pmusgrave/synth-wavetable/Cypress/ComponentUpdateLog.txt

Last Modified Date & Time: 09/27/2019 14:22:59

synth-wavetable: TopDesign.cysch
	USB [v3.10] to [v3.20]

Last Modified Date & Time: 09/27/2019 14:25:36

synth-wavetable: TopDesign.cysch
	CodecI2CM [v4.0] to [v3.20]
	UART [v4.0] to [v3.20]
	USB [v3.20] to [v3.10]

Last Modified Date & Time: 09/27/2019 14:26:23

synth-wavetable: TopDesign.cysch
	CodecI2CM [v3.20] to [v4.0]
	UART [v3.20] to [v4.0]
	USB [v3.10] to [v3.20]

Last Modified Date & Time: 09/27/2019 14:26:39

synth-wavetable: TopDesign.cysch
	CodecI2CM [v4.0] to [v3.20]
	UART [v4.0] to [v3.20]

Last Modified Date & Time: 09/27/2019 14:26:55

synth-wavetable: TopDesign.cysch
	USB [v3.20] to [v3.10]

Last Modified Date & Time: 09/27/2019 14:36:18

synth-wavetable: TopDesign.cysch
	CodecI2CM [v3.20] to [v4.0]
	UART [v3.20] to [v4.0]
