pmusgrave/synth-wavetable/Hardware/synth-engine/synth-wavetable.pdf

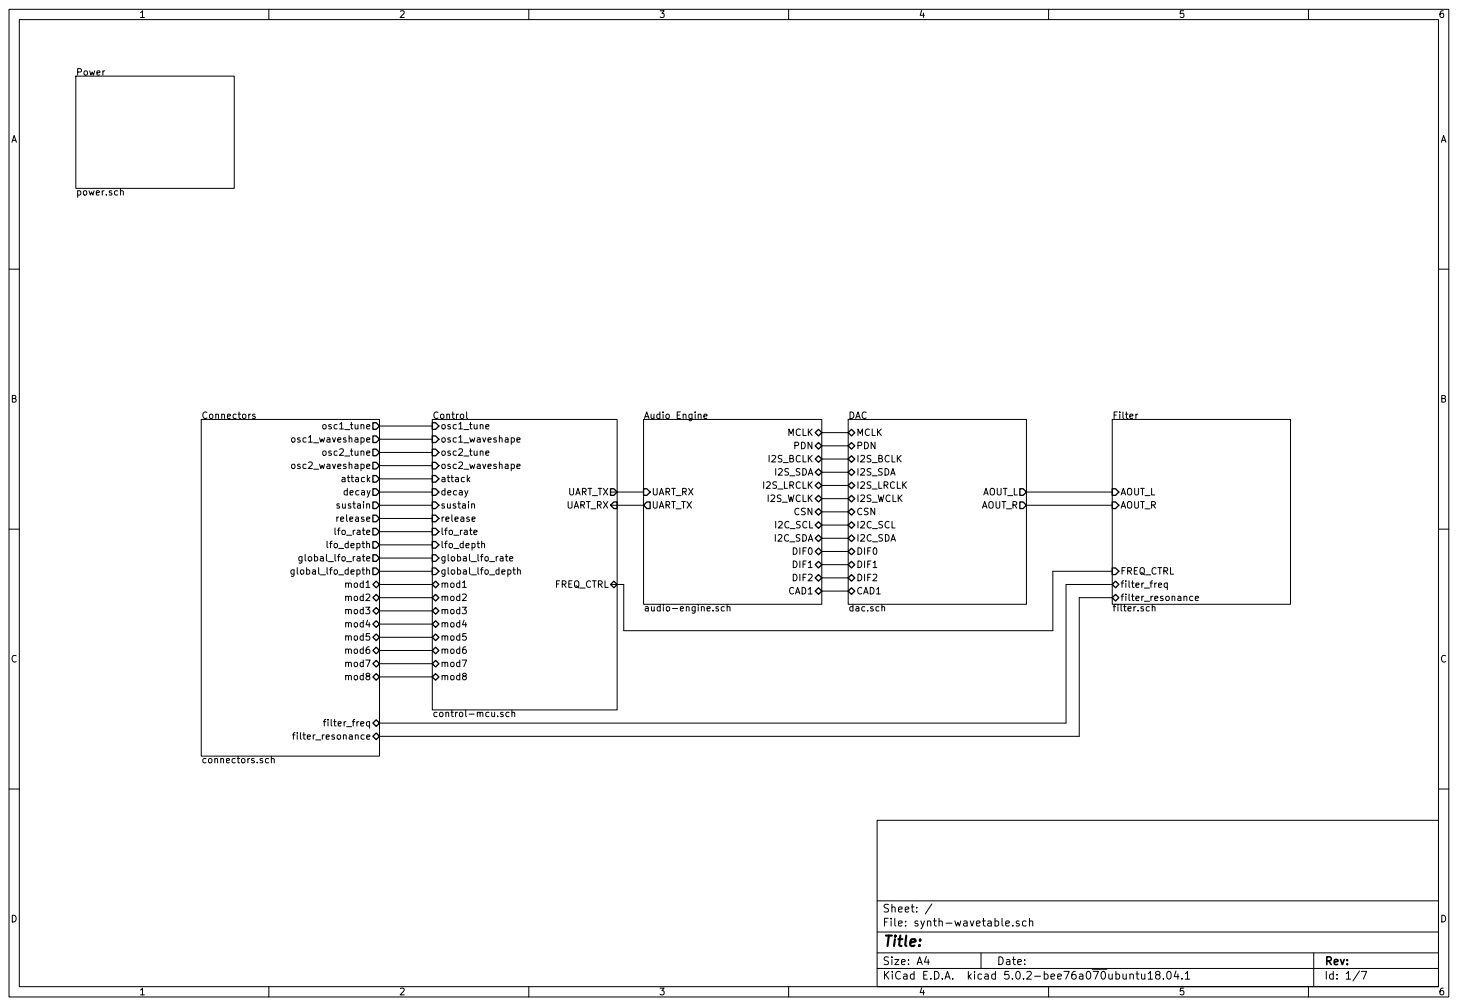
[picture p1: page 1]

File: synth-wavetable.sch Sheet: /
Id: 1/7 Title:

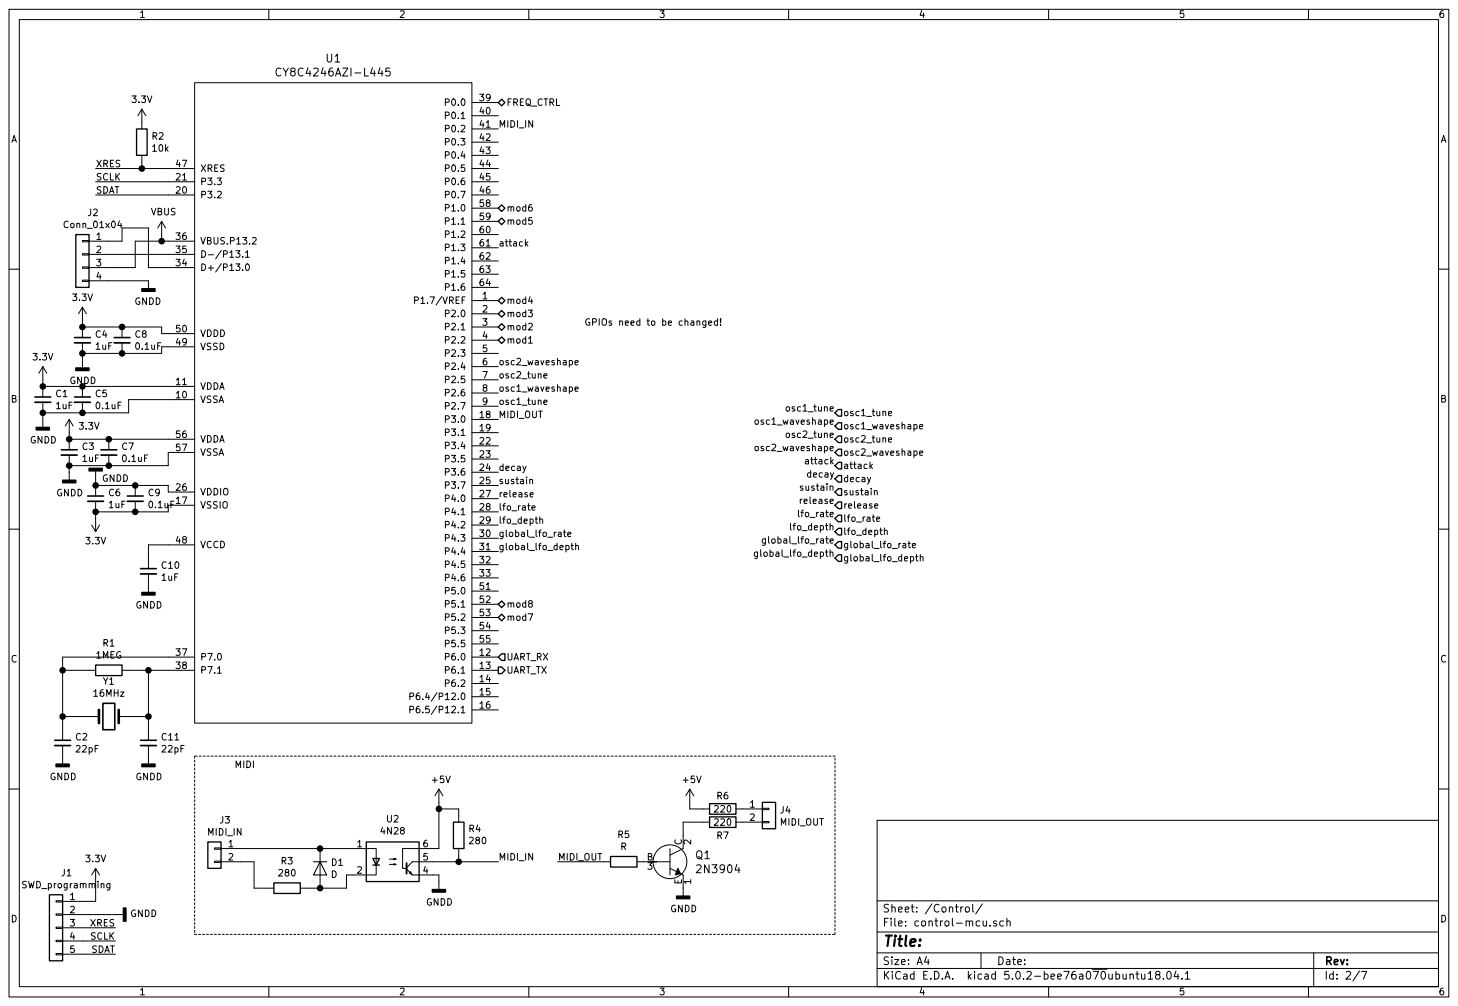
[picture p2: page 2]

GPIOs need to be changed! FREQ_CTRL mod1 mod2 mod3 mod4 mod5 mod6 mod7 mod8 VBUS 1234

Id: 2/7 Title: File: control-mcu.sch Sheet: /Control/

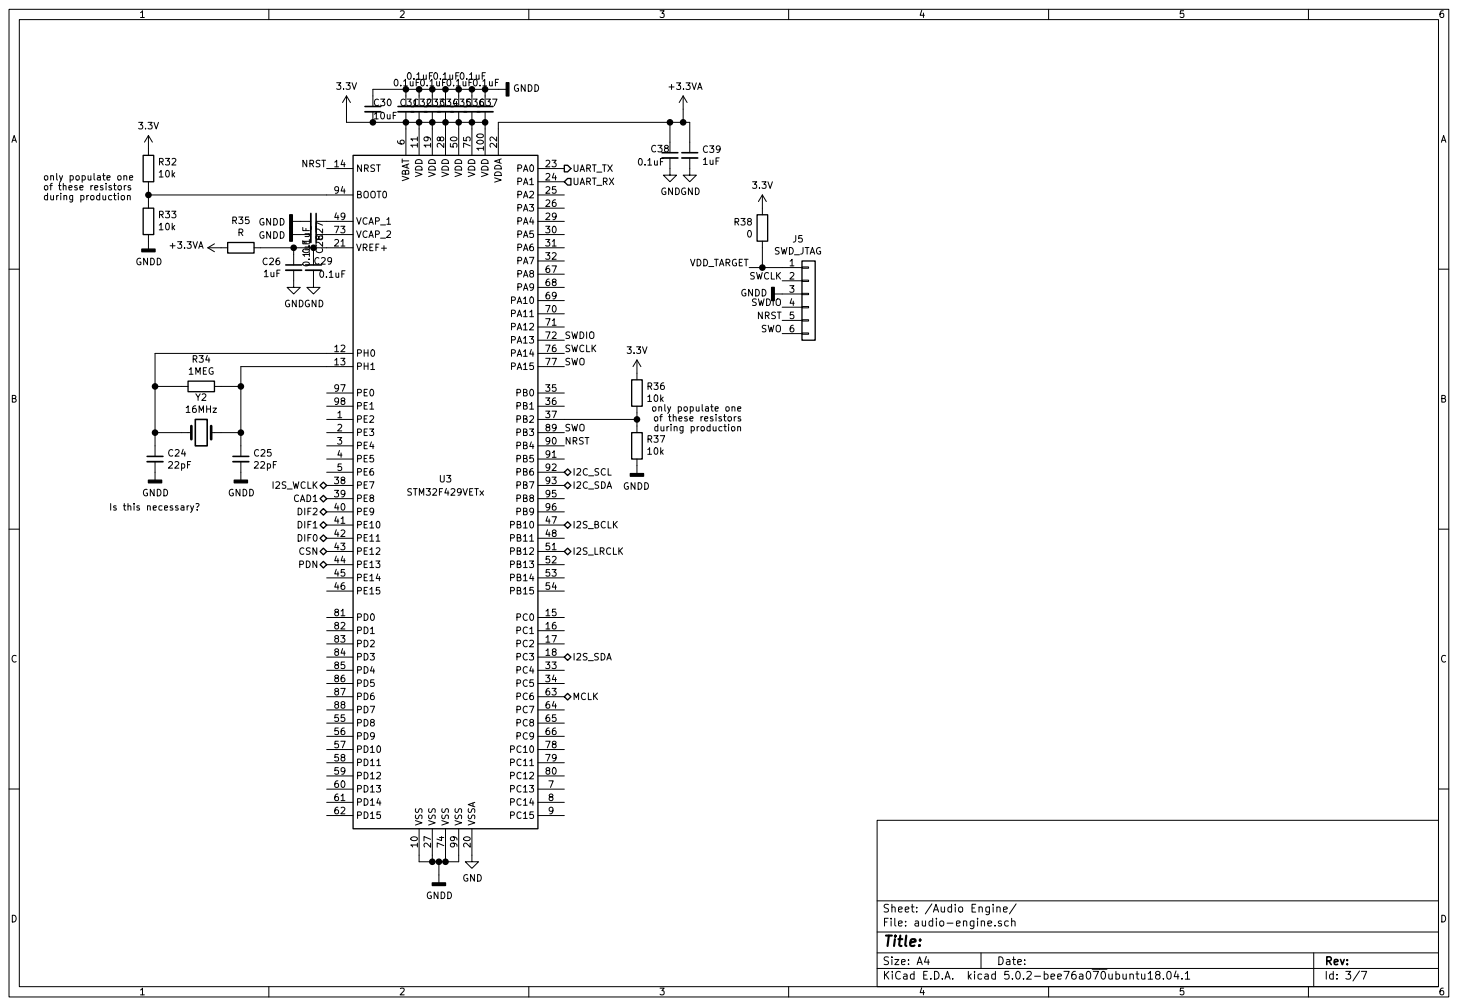
[picture p3: page 3]

10k only populate one
of these resistors during production

Sheet: /Audio Engine/
File: audio-engine.sch
Id: 3/7 Title:

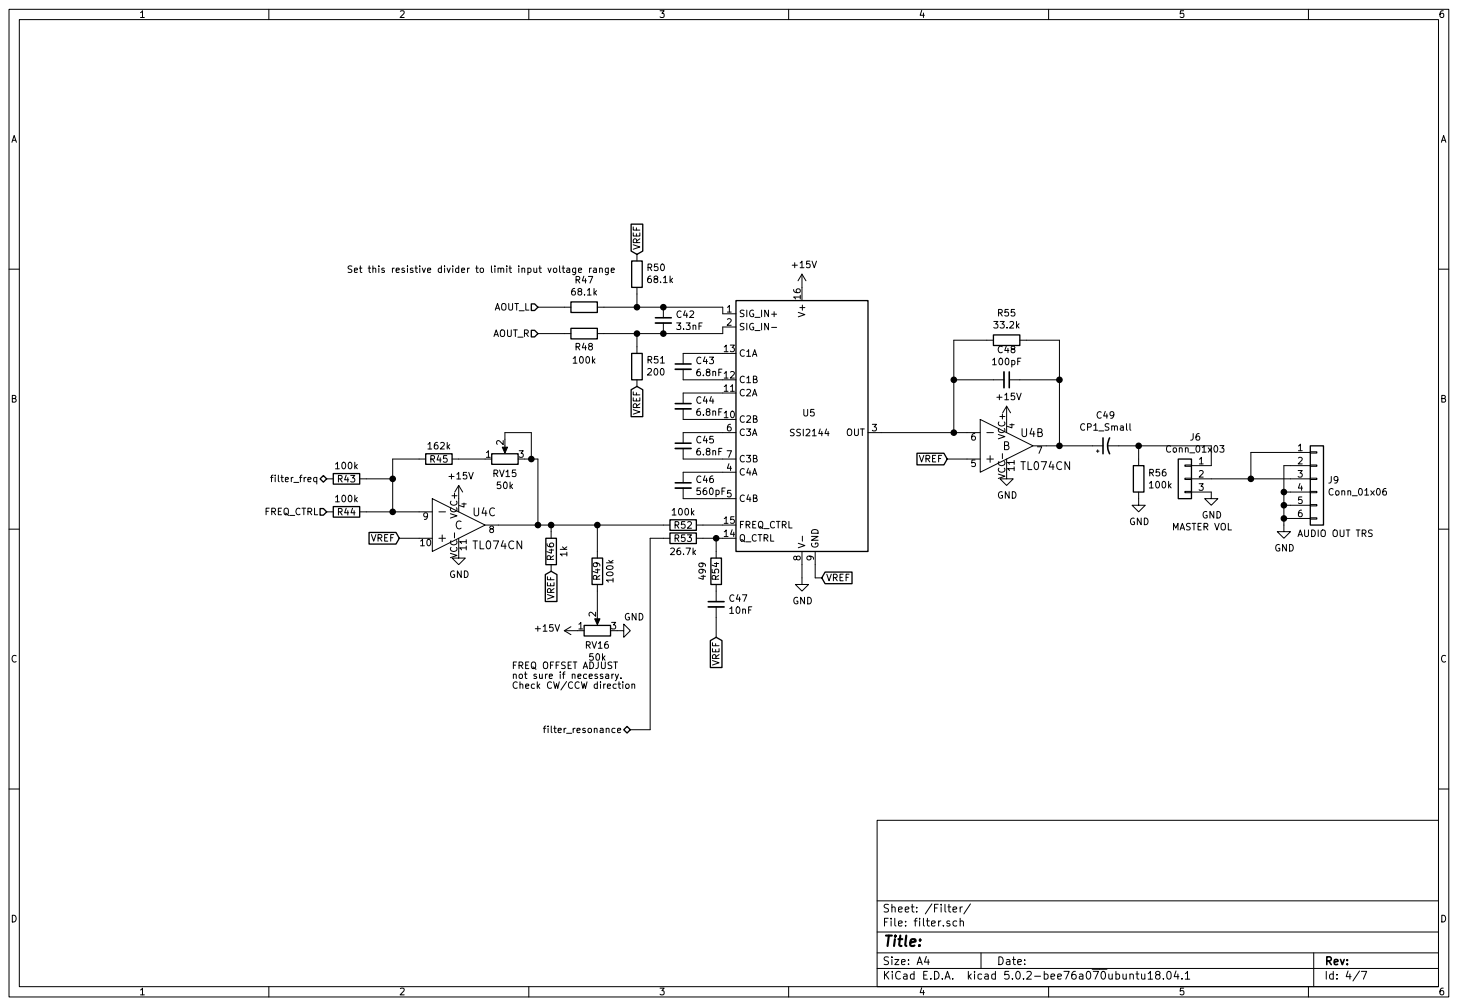
[picture p4: page 4]

68.1k Set this resistive divider to limit input voltage range R43

FREQ OFFSET ADJUST
not sure if necessary. Check CW/CCW direction

Id: 4/7 Title: File: filter.sch Sheet: /Filter/

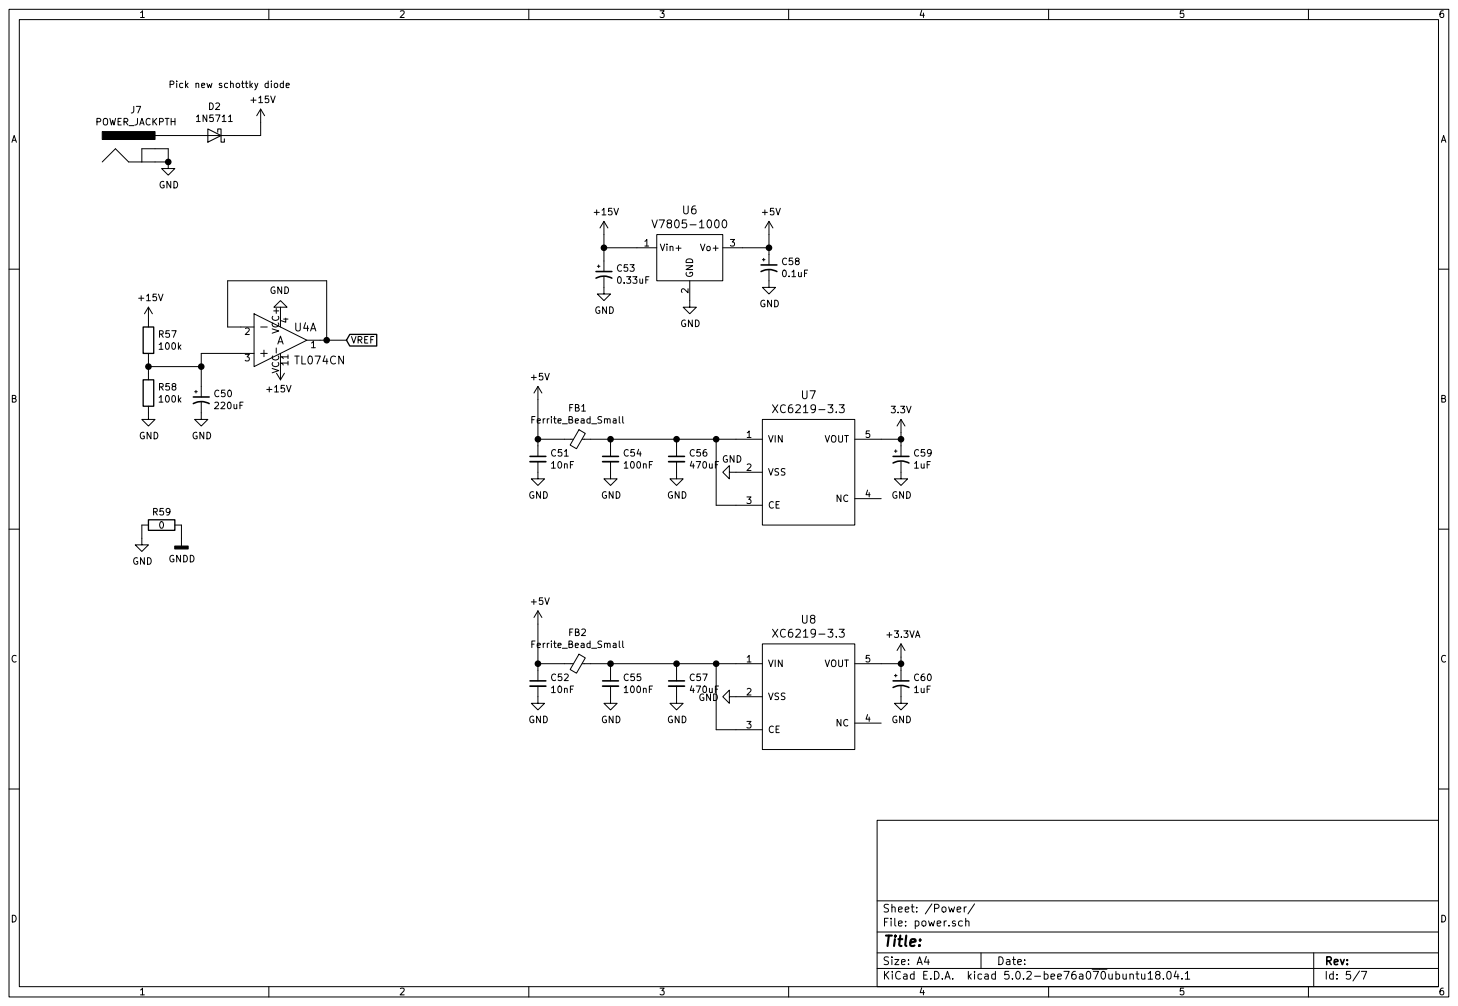
[picture p5: page 5]

1N5711 Pick new schottky diode

File: power.sch Sheet: /Power/
Id: 5/7 Title:

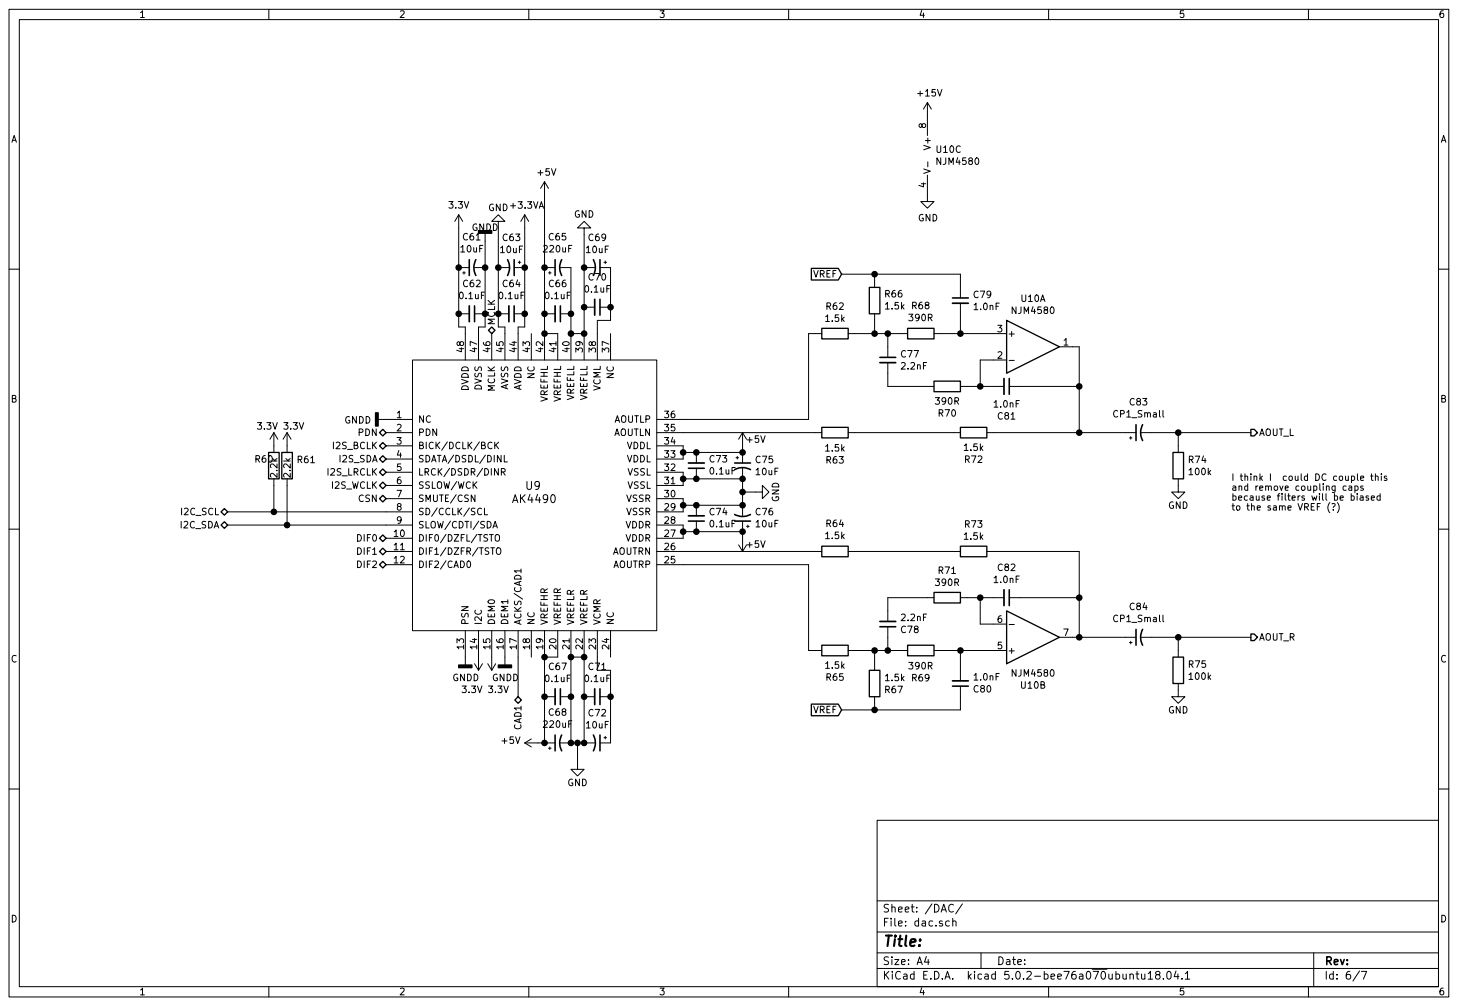
[picture p6: page 6]

I think I could DC couple this
and remove coupling caps because filters will be biased
to the same VREF (?)

Id: 6/7 Title: File: dac.sch Sheet: /DAC/

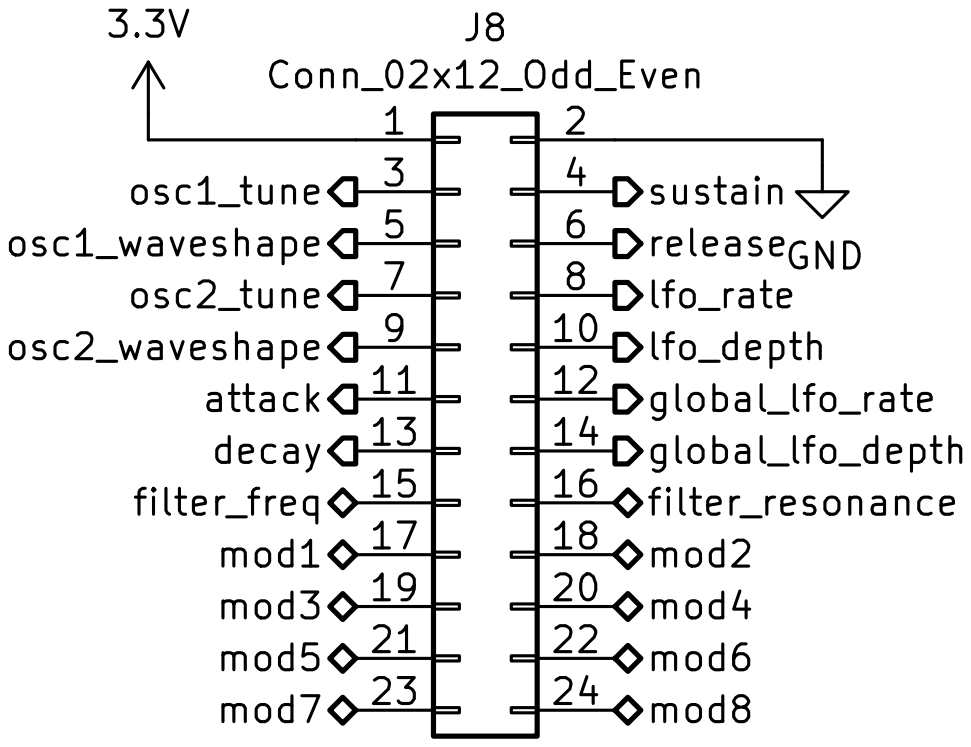
[picture p7: page 7]

Id: 7/7 Title: File: connectors.sch Sheet: /Connectors/
