pmusgrave/synth-wavetable/Hardware/synth-engine/synth-wavetable.kicad_pcb

## KiCad design Hardware/synth-engine/synth-wavetable.kicad_pcb (2019-12-03)

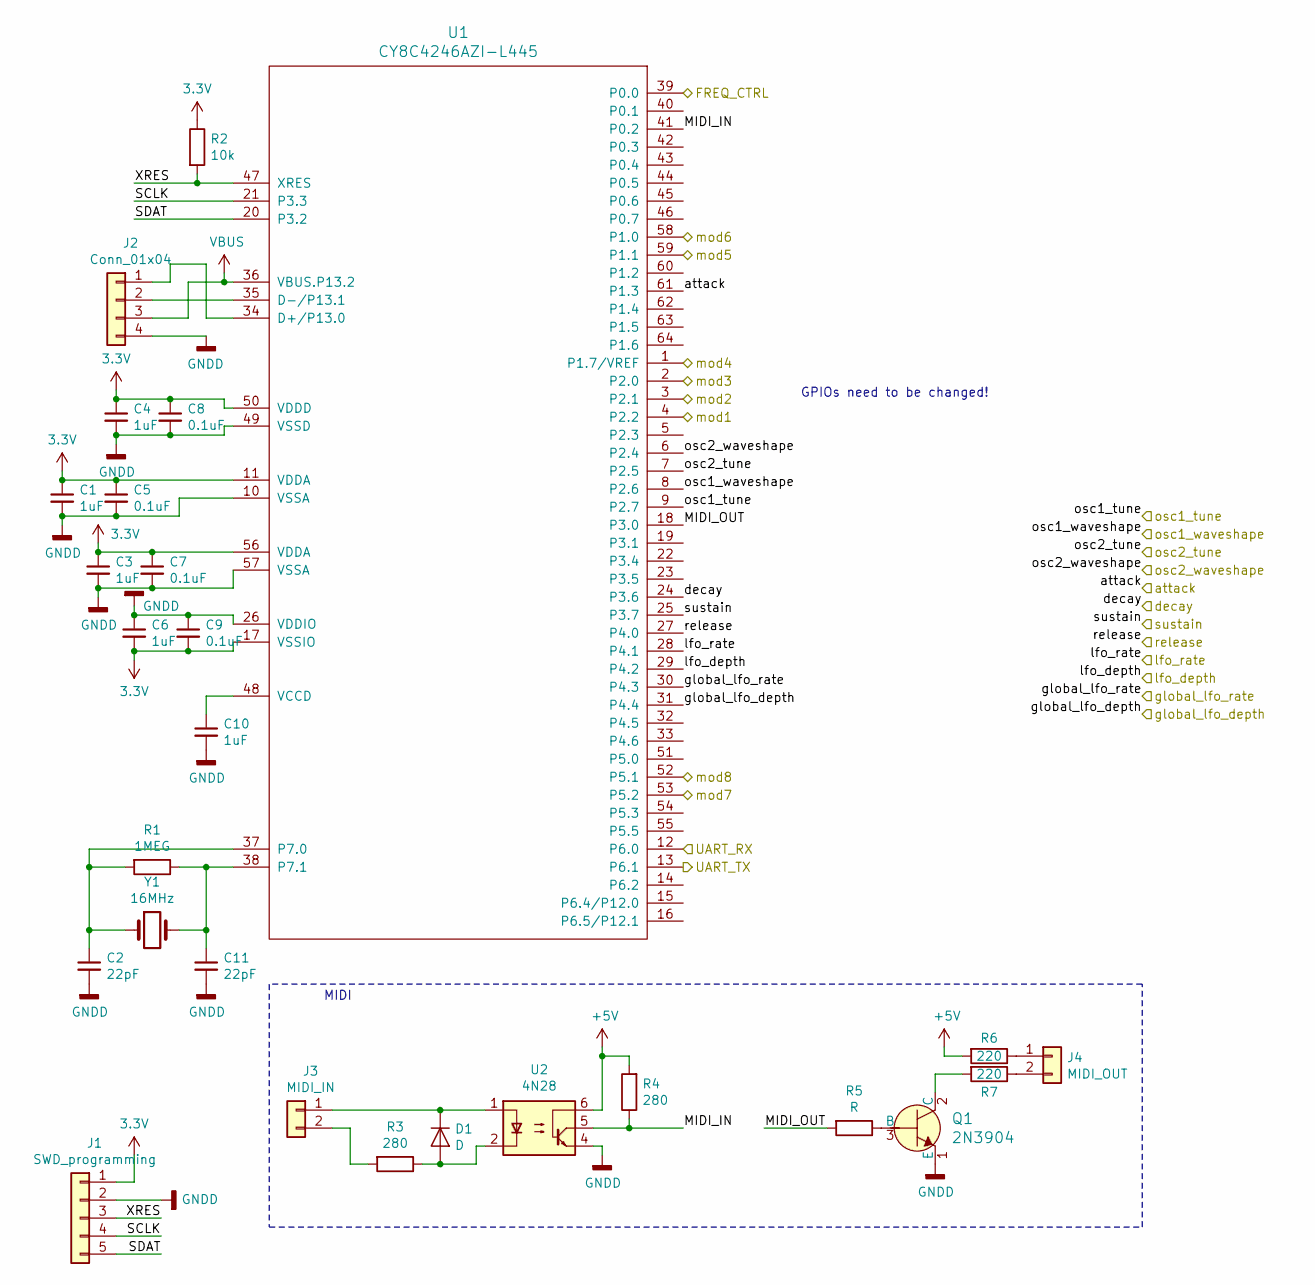
[picture p8: schematic control-mcu.sch]

Parts:
C1, C3, C4, C6, C10: 1uF; 0805
C2, C11: 22pF; 0805
C5, C7, C8, C9: 0.1uF; 0805
D1: D; 1210
J1: SWD_programming; 1X05
J2: Conn_01x04; 1X04
J3: MIDI_IN; 1X02
J4: MIDI_OUT; 1X02
Q1: 2N3904; SOT23-3; MPN 2N3904; Digi-Key_PN 2N3904CS-ND
R1: 1MEG; 0805
R2: 10k; 0805
R3, R4: 280; 0805
R5: R; 0805
R6, R7: 220; 0805
U1: CY8C4246AZI-L445; TQFP64
U2: 4N28; DIL-08
Y1: 16MHz; Crystal_SMD_HC49-SD_HandSoldering

Connections:
3.3V: C1.1, C3.1, C4.1, C5.1, C6.2, C7.1, C8.1, C9.2, J1.1, R2.1, U1.11 (VDDA), U1.17 (VSSIO), U1.50 (VDDD), U1.56 (VDDA); also elsewhere on the board
+5V: R4.2, R6.2, U2.6; also elsewhere on the board
/Connectors/attack: U1.61 (P1.3); also elsewhere on the board
/Connectors/decay: U1.24 (P3.6); also elsewhere on the board
/Connectors/global_lfo_depth: U1.31 (P4.4); also elsewhere on the board
/Connectors/global_lfo_rate: U1.30 (P4.3); also elsewhere on the board
/Connectors/lfo_depth: U1.29 (P4.2); also elsewhere on the board
/Connectors/lfo_rate: U1.28 (P4.1); also elsewhere on the board
/Connectors/mod1: U1.4 (P2.2); also elsewhere on the board
/Connectors/mod2: U1.3 (P2.1); also elsewhere on the board
/Connectors/mod3: U1.2 (P2.0); also elsewhere on the board
/Connectors/mod4: U1.1 (P1.7/VREF); also elsewhere on the board
/Connectors/mod5: U1.59 (P1.1); also elsewhere on the board
/Connectors/mod6: U1.58 (P1.0); also elsewhere on the board
/Connectors/mod7: U1.53 (P5.2); also elsewhere on the board
/Connectors/mod8: U1.52 (P5.1); also elsewhere on the board
/Connectors/osc1_tune: U1.9 (P2.7); also elsewhere on the board
/Connectors/osc1_waveshape: U1.8 (P2.6); also elsewhere on the board
/Connectors/osc2_tune: U1.7 (P2.5); also elsewhere on the board
/Connectors/osc2_waveshape: U1.6 (P2.4); also elsewhere on the board
/Connectors/release: U1.27 (P4.0); also elsewhere on the board
/Connectors/sustain: U1.25 (P3.7); also elsewhere on the board
/Control/FREQ_CTRL: U1.39 (P0.0)
/Control/MIDI_IN: R4.1, U1.41 (P0.2), U2.5
/Control/MIDI_OUT: R5.2, U1.18 (P3.0)
/Control/SCLK: J1.4, U1.21 (P3.3)
/Control/SDAT: J1.5, U1.20 (P3.2)
/Control/UART_RX: U1.12 (P6.0)
/Control/UART_TX: U1.13 (P6.1)
/Control/XRES: J1.3, R2.2, U1.47 (XRES)
GNDD: C1.2, C2.2, C3.2, C4.2, C5.2, C6.1, C7.2, C8.2, C9.1, C10.2, C11.2, J1.2, J2.4, Q1.1 (E), U1.10 (VSSA), U1.26 (VDDIO), U1.49 (VSSD), U1.57 (VSSA), U2.4; also elsewhere on the board
unnamed: C2.1, R1.2, U1.37 (P7.0), Y1.1
unnamed: C10.1, U1.48 (VCCD)
unnamed: C11.1, R1.1, U1.38 (P7.1), Y1.2
unnamed: D1.1 (K), J3.1, U2.1
unnamed: D1.2 (A), R3.1, U2.2
unnamed: J2.1, U1.34 (D+/P13.0)
unnamed: J2.2, U1.35 (D-/P13.1)
unnamed: J3.2, R3.2
unnamed: J4.1, R6.1
unnamed: J4.2, R7.1
unnamed: Q1.2 (C), R7.2
unnamed: Q1.3 (B), R5.1
VBUS: J2.3, U1.36 (VBUS.P13.2)

Notes on the sheet:
MIDI
GPIOs need to be changed!

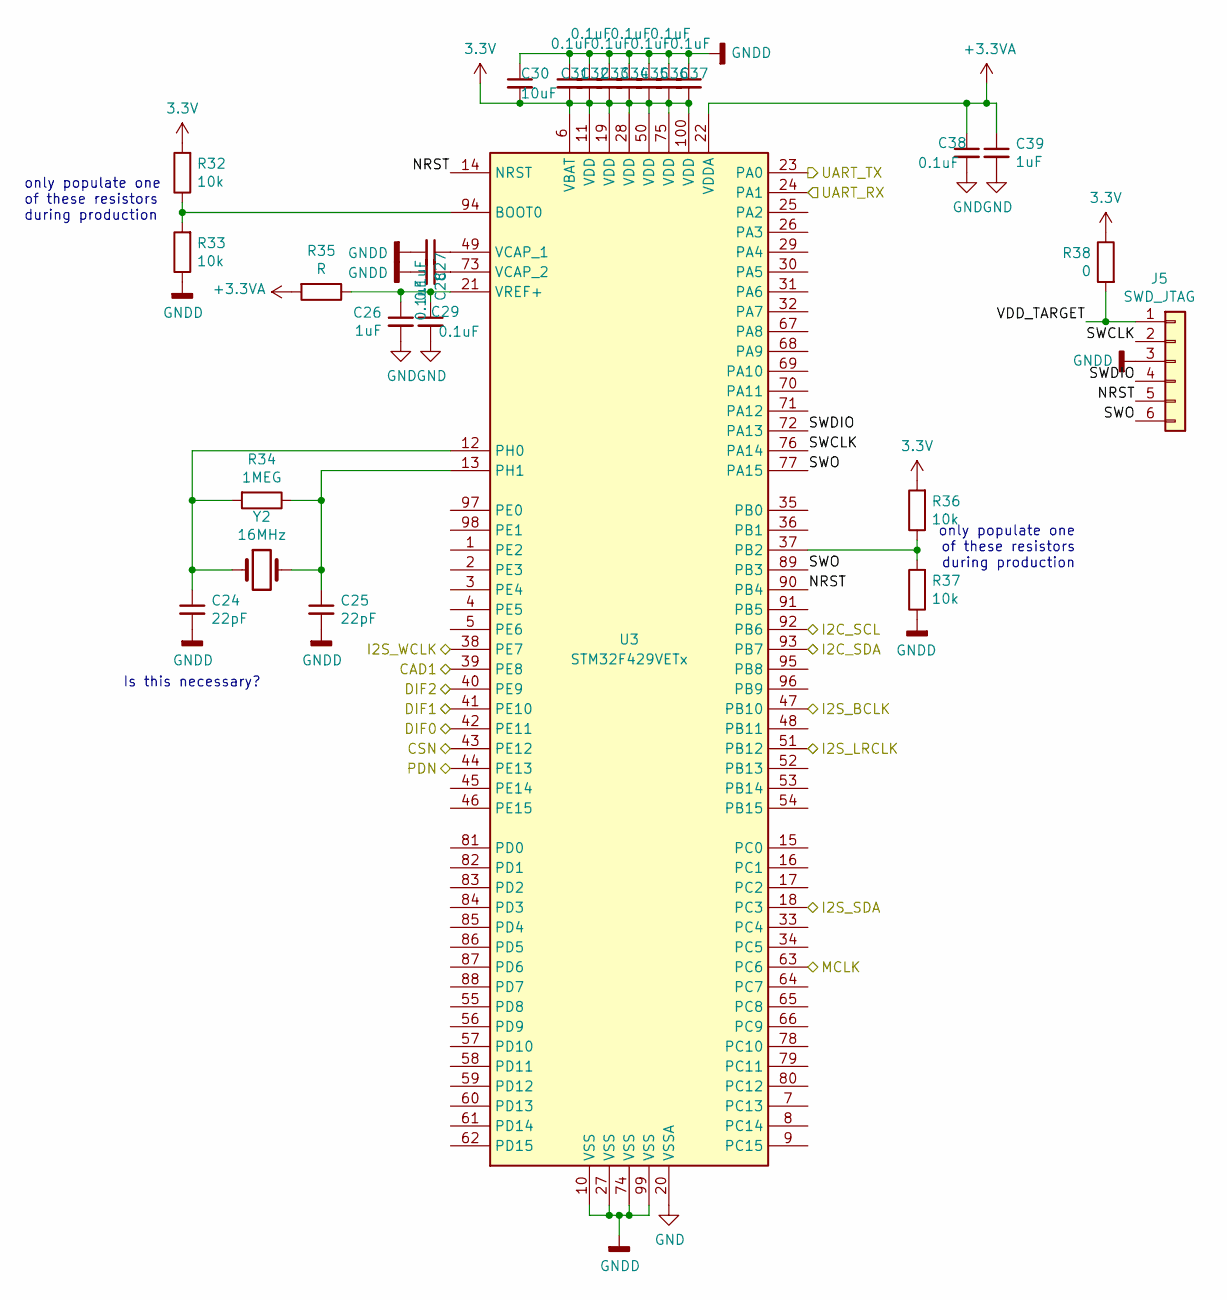
[picture p9: schematic audio-engine.sch]

Parts:
C24, C25: 22pF; 0805
C26, C39: 1uF; 0805
C27, C28, C29, C31, C32, C33, C34, C35, C36, C37, C38: 0.1uF; 0805
C30: 10uF; 0805
J5: SWD_JTAG; 1X06
R32, R33, R36, R37: 10k; 0805
R34: 1MEG; 0805
R35: R; 0805
R38: 0; 0805
U3: STM32F429VETx; LQFP-100_14x14mm_P0.5mm
Y2: 16MHz; Crystal_SMD_HC49-SD_HandSoldering

Connections:
3.3V: C30.2, C31.2, C32.2, C33.2, C34.2, C35.2, C36.2, C37.2, R32.2, R36.2, R38.1, U3.6 (VBAT), U3.11 (VDD), U3.19 (VDD), U3.28 (VDD), U3.50 (VDD), U3.75 (VDD), U3.100 (VDD); also elsewhere on the board
+3.3VA: C38.1, C39.1, R35.2, U3.22 (VDDA); also elsewhere on the board
/Audio Engine/CAD1: U3.39 (PE8); also elsewhere on the board
/Audio Engine/CSN: U3.43 (PE12); also elsewhere on the board
/Audio Engine/DIF0: U3.42 (PE11); also elsewhere on the board
/Audio Engine/DIF1: U3.41 (PE10); also elsewhere on the board
/Audio Engine/DIF2: U3.40 (PE9); also elsewhere on the board
/Audio Engine/I2C_SCL: U3.92 (PB6); also elsewhere on the board
/Audio Engine/I2C_SDA: U3.93 (PB7); also elsewhere on the board
/Audio Engine/I2S_BCLK: U3.47 (PB10); also elsewhere on the board
/Audio Engine/I2S_LRCLK: U3.51 (PB12); also elsewhere on the board
/Audio Engine/I2S_SDA: U3.18 (PC3); also elsewhere on the board
/Audio Engine/I2S_WCLK: U3.38 (PE7); also elsewhere on the board
/Audio Engine/MCLK: U3.63 (PC6); also elsewhere on the board
/Audio Engine/NRST: J5.5, U3.14 (NRST), U3.90 (PB4)
/Audio Engine/PDN: U3.44 (PE13); also elsewhere on the board
/Audio Engine/SWCLK: J5.2, U3.76 (PA14)
/Audio Engine/SWDIO: J5.4, U3.72 (PA13)
/Audio Engine/SWO: J5.6, U3.77 (PA15), U3.89 (PB3)
/Audio Engine/UART_RX: U3.24 (PA1)
/Audio Engine/UART_TX: U3.23 (PA0)
/Audio Engine/VDD_TARGET: J5.1, R38.2
GNDD: C24.2, C25.2, C27.2, C28.2, C30.1, C31.1, C32.1, C33.1, C34.1, C35.1, C36.1, C37.1, J5.3, R33.1, R37.1, U3.10 (VSS), U3.27 (VSS), U3.74 (VSS), U3.99 (VSS); also elsewhere on the board
unnamed: C24.1, R34.2, U3.12 (PH0), Y2.1
unnamed: C25.1, R34.1, U3.13 (PH1), Y2.2
unnamed: C26.1, C29.1, R35.1, U3.21 (VREF+)
unnamed: C27.1, U3.49 (VCAP_1)
unnamed: C28.1, U3.73 (VCAP_2)
unnamed: R32.1, R33.2, U3.94 (BOOT0)
unnamed: R36.1, R37.2, U3.37 (PB2)

Notes on the sheet:
only populate one of these resistors during production
Is this necessary?

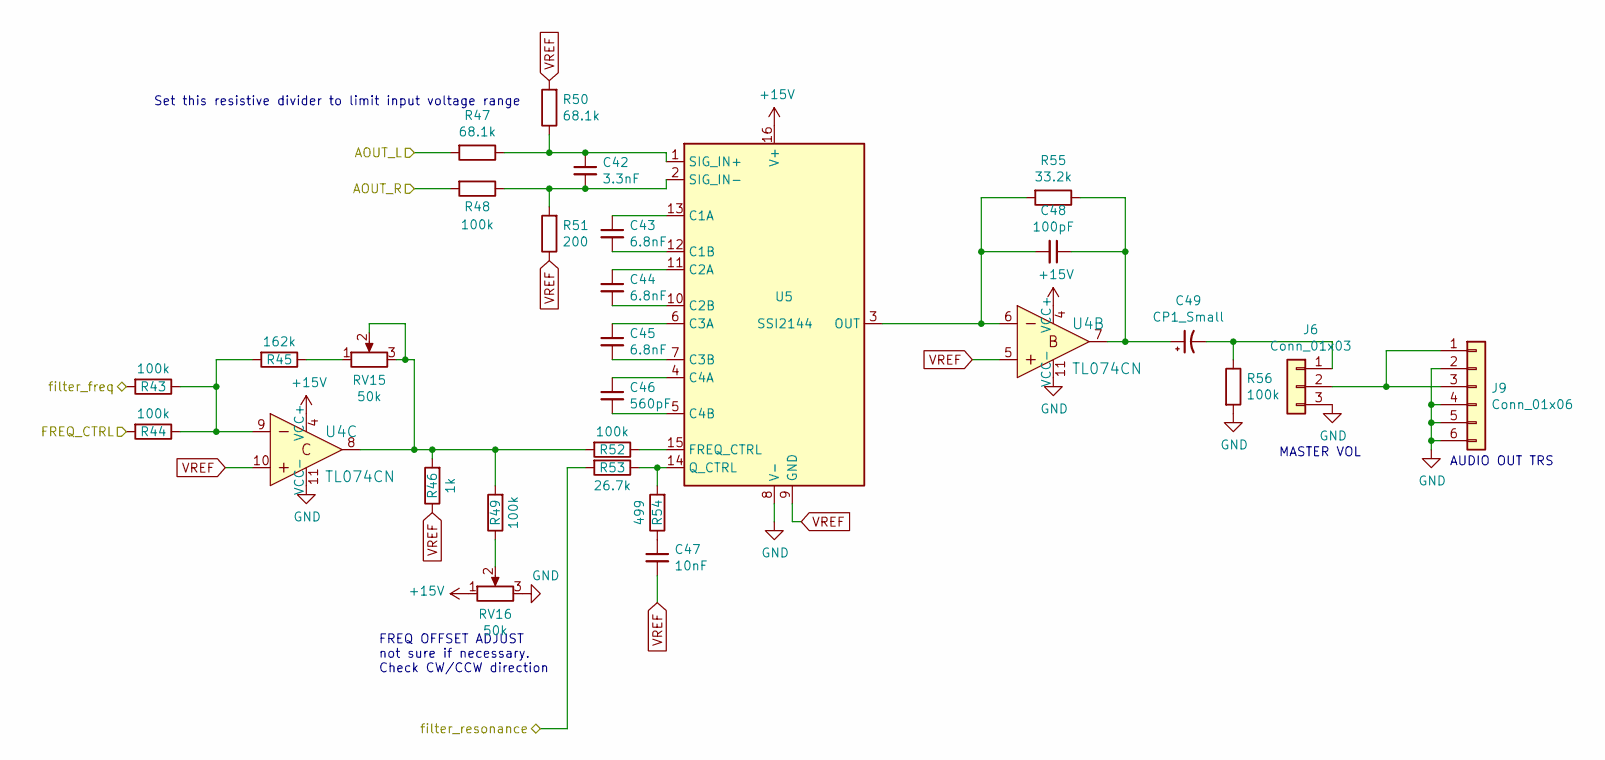
[picture p10: schematic filter.sch]

Parts:
C42: 3.3nF; 0805
C43, C44, C45: 6.8nF; 0805
C46: 560pF; 0805
C47: 10nF; 0805
C48: 100pF; 0805
C49: CP1_Small; CP_Elec_6.3x5.4
J6: Conn_01x03; 1X03
J9: Conn_01x06; 1X06
R43, R44, R48, R49, R52, R56: 100k; 0805
R45: 162k; 0805
R46: 1k; 0805
R47, R50: 68.1k; 0805
R51: 200; 0805
R53: 26.7k; 0805
R54: 499; 0805
R55: 33.2k; 0805
RV15, RV16: 50k; TRIMPOT-3MM-2
U4: TL074CN; SO16; MPN TL074CN; Digi-Key_PN 296-1777-5-ND
U5: SSI2144; SSOP16

Connections:
/Connectors/filter_freq: R43.2; also elsewhere on the board
/Connectors/filter_resonance: R53.2; also elsewhere on the board
/DAC/AOUT_L: R47.2; also elsewhere on the board
/DAC/AOUT_R: R48.2; also elsewhere on the board
/Filter/FREQ_CTRL: R44.2
unnamed: C42.1, R47.1, R50.1, U5.1 (SIG_IN+)
unnamed: C42.2, R48.1, R51.2, U5.2 (SIG_IN-)
unnamed: C43.1, U5.13 (C1A)
unnamed: C43.2, U5.12 (C1B)
unnamed: C44.1, U5.11 (C2A)
unnamed: C44.2, U5.10 (C2B)
unnamed: C45.1, U5.6 (C3A)
unnamed: C45.2, U5.7 (C3B)
unnamed: C46.1, U5.4 (C4A)
unnamed: C46.2, U5.5 (C4B)
unnamed: C47.1, R54.1
unnamed: C48.1, C49.1, R55.1, U4.7
unnamed: C48.2, R55.2, U4.6, U5.3 (OUT)
unnamed: C49.2, J6.1, R56.1
unnamed: J6.2, J9.1, J9.3
unnamed: R43.1, R44.1, R45.2, U4.9
unnamed: R45.1, RV15.1
unnamed: R46.2, R49.2, R52.2, RV15.2, RV15.3, U4.8
unnamed: R49.1, RV16.2
unnamed: R52.1, U5.15 (FREQ_CTRL)
unnamed: R53.1, R54.2, U5.14 (Q_CTRL)
VREF: C47.2, R46.1, R50.2, R51.1, U4.5, U4.10, U5.9 (GND); also elsewhere on the board

Notes on the sheet:
FREQ OFFSET ADJUST not sure if necessary. Check CW/CCW direction
Set this resistive divider to limit input voltage range
MASTER VOL
AUDIO OUT TRS

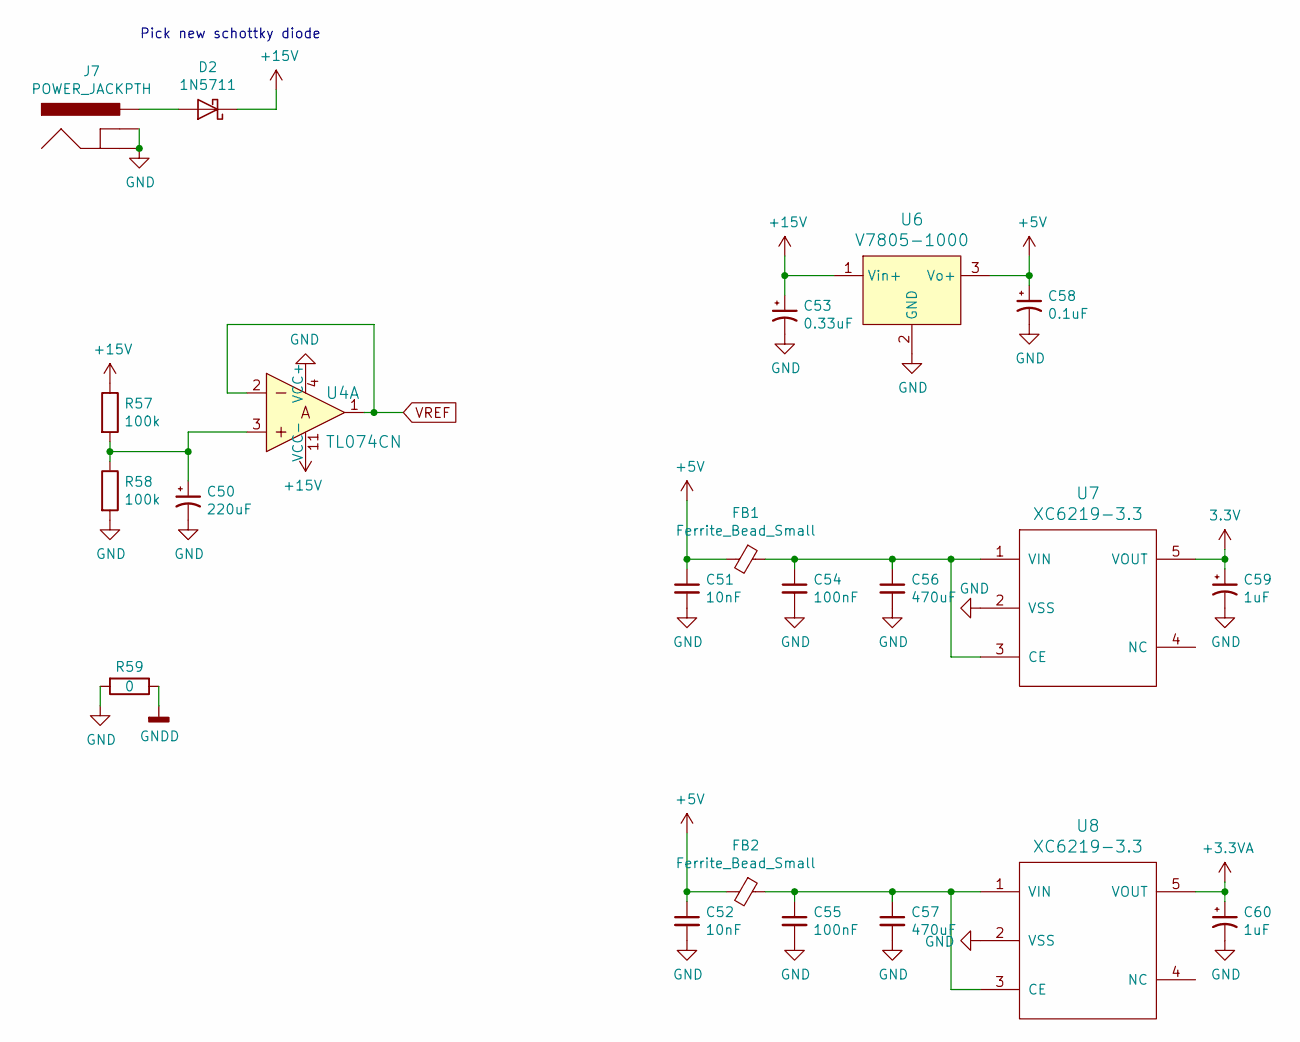
[picture p11: schematic power.sch]

Parts:
C50: 220uF; CP_Elec_6.3x5.4
C51, C52: 10nF; 0805
C53: 0.33uF; 0805
C54, C55: 100nF; 0805
C56, C57: 470uF; CP_Elec_6.3x5.4
C58: 0.1uF; 0805
C59, C60: 1uF; 0805
D2: 1N5711; 1210
FB1, FB2: Ferrite_Bead_Small; 0805
J7: POWER_JACKPTH; POWER_JACK_PTH
R57, R58: 100k; 0805
R59: 0; 0805
U4: TL074CN; SO16; MPN TL074CN; Digi-Key_PN 296-1777-5-ND
U6: V7805-1000; TO220V; MPN V7805-1000; Digi-Key_PN 102-1715-ND
U7, U8: XC6219-3.3; SOT23-5

Connections:
3.3V: C59.1, U7.5 (VOUT); also elsewhere on the board
+3.3VA: C60.1, U8.5 (VOUT); also elsewhere on the board
+5V: C51.1, C52.1, C58.1, FB1.2, FB2.2, U6.3 (Vo+); also elsewhere on the board
GNDD: R59.1; also elsewhere on the board
unnamed: C50.1, R57.2, R58.1, U4.3
unnamed: C54.1, C56.1, FB1.1, U7.1 (VIN), U7.3 (CE)
unnamed: C55.1, C57.1, FB2.1, U8.1 (VIN), U8.3 (CE)
unnamed: D2.2 (A), J7.PWR
VREF: U4.1, U4.2; also elsewhere on the board

Notes on the sheet:
Pick new schottky diode

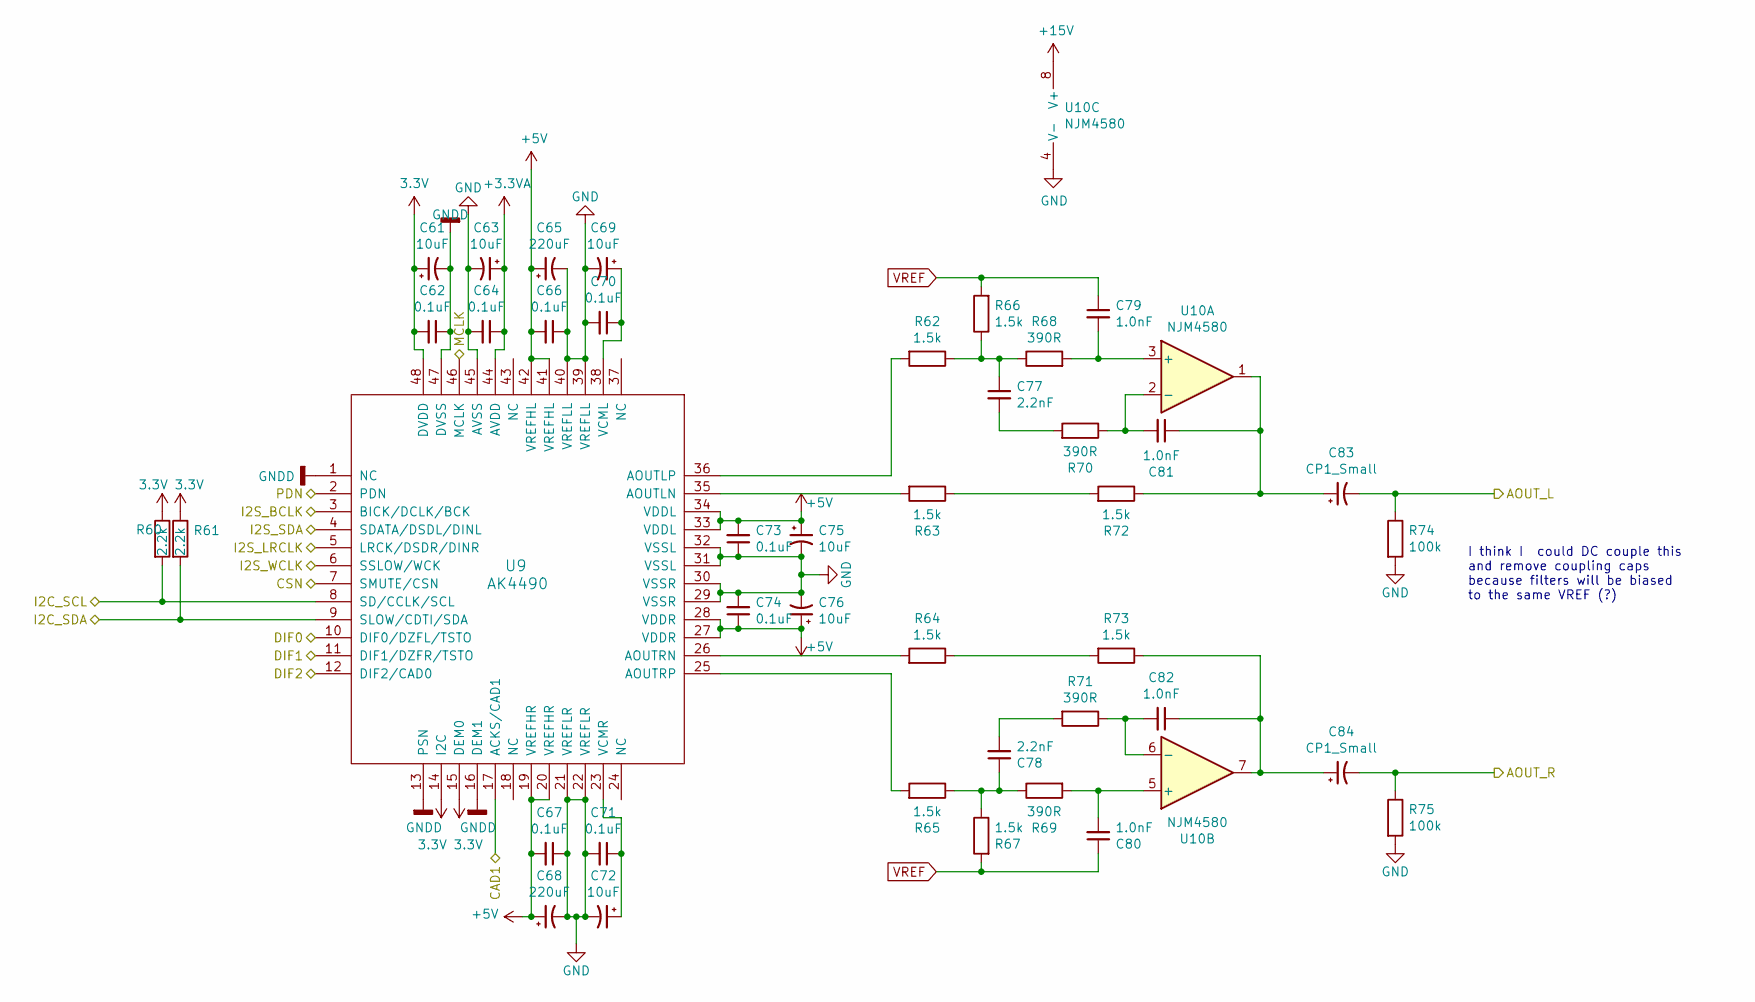
[picture p12: schematic dac.sch]

Parts:
C61, C63, C69, C72, C75, C76: 10uF; CP_Elec_6.3x5.4
C62, C64, C66, C67, C70, C71, C73, C74: 0.1uF; 0805
C65, C68: 220uF; CP_Elec_6.3x5.4
C77, C78: 2.2nF; 0805
C79, C80, C81, C82: 1.0nF; 0805
C83, C84: CP1_Small; CP_Elec_6.3x5.4
R60, R61: 2.2k; 0805
R62, R63, R64, R65, R66, R67, R72, R73: 1.5k; 0805
R68, R69, R70, R71: 390R; 0805
R74, R75: 100k; 0805
U9: AK4490; LQFP-48
U10: NJM4580; SO08

Connections:
3.3V: C61.1, C62.2, R60.1, R61.1, U9.14 (I2C), U9.15 (DEM0), U9.48 (DVDD); also elsewhere on the board
+3.3VA: C63.1, C64.1, U9.44 (AVDD); also elsewhere on the board
+5V: C65.1, C66.2, C67.2, C68.1, C73.2, C74.1, C75.1, C76.1, U9.19 (VREFHR), U9.20 (VREFHR), U9.27 (VDDR), U9.28 (VDDR), U9.33 (VDDL), U9.34 (VDDL), U9.41 (VREFHL), U9.42 (VREFHL); also elsewhere on the board
/Audio Engine/CAD1: U9.17 (ACKS/CAD1); also elsewhere on the board
/Audio Engine/CSN: U9.7 (SMUTE/CSN); also elsewhere on the board
/Audio Engine/DIF0: U9.10 (DIF0/DZFL/TSTO); also elsewhere on the board
/Audio Engine/DIF1: U9.11 (DIF1/DZFR/TSTO); also elsewhere on the board
/Audio Engine/DIF2: U9.12 (DIF2/CAD0); also elsewhere on the board
/Audio Engine/I2C_SCL: R60.2, U9.8 (SD/CCLK/SCL); also elsewhere on the board
/Audio Engine/I2C_SDA: R61.2, U9.9 (SLOW/CDTI/SDA); also elsewhere on the board
/Audio Engine/I2S_BCLK: U9.3 (BICK/DCLK/BCK); also elsewhere on the board
/Audio Engine/I2S_LRCLK: U9.5 (LRCK/DSDR/DINR); also elsewhere on the board
/Audio Engine/I2S_SDA: U9.4 (SDATA/DSDL/DINL); also elsewhere on the board
/Audio Engine/I2S_WCLK: U9.6 (SSLOW/WCK); also elsewhere on the board
/Audio Engine/MCLK: U9.46 (MCLK); also elsewhere on the board
/Audio Engine/PDN: U9.2 (PDN); also elsewhere on the board
/DAC/AOUT_L: C83.2, R74.1; also elsewhere on the board
/DAC/AOUT_R: C84.2, R75.1; also elsewhere on the board
GNDD: C61.2, C62.1, U9.1 (NC), U9.13 (PSN), U9.16 (DEM1), U9.47 (DVSS); also elsewhere on the board
unnamed: C69.1, C70.1, U9.38 (VCML)
unnamed: C71.1, C72.1, U9.23 (VCMR)
unnamed: C77.1, R62.1, R66.1, R68.1
unnamed: C77.2, R70.2
unnamed: C78.1, R65.1, R67.1, R69.1
unnamed: C78.2, R71.2
unnamed: C79.2, R68.2, U10.3 (+)
unnamed: C80.2, R69.2, U10.5 (+)
unnamed: C81.1, C83.1, R72.1, U10.1
unnamed: C81.2, R70.1, U10.2 (-)
unnamed: C82.1, C84.1, R73.1, U10.7
unnamed: C82.2, R71.1, U10.6 (-)
unnamed: R62.2, U9.36 (AOUTLP)
unnamed: R63.1, R72.2
unnamed: R63.2, U9.35 (AOUTLN)
unnamed: R64.1, R73.2
unnamed: R64.2, U9.26 (AOUTRN)
unnamed: R65.2, U9.25 (AOUTRP)
VREF: C79.1, C80.1, R66.2, R67.2; also elsewhere on the board

Notes on the sheet:
I think I could DC couple this and remove coupling caps because filters will be biased to the same VREF (?)

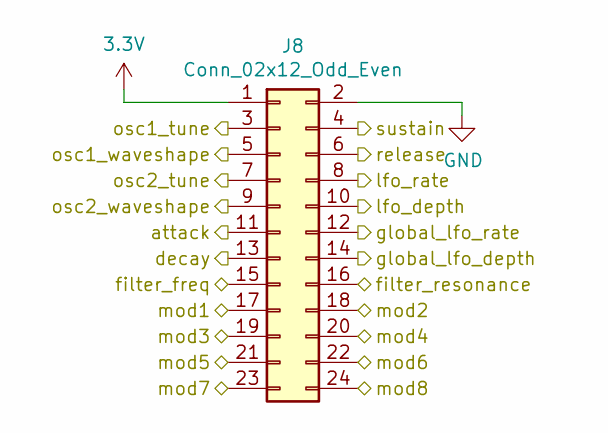
[picture p13: schematic connectors.sch]

Parts:
J8: Conn_02x12_Odd_Even; 2X12

Connections:
3.3V: J8.1; also elsewhere on the board
/Connectors/attack: J8.11; also elsewhere on the board
/Connectors/decay: J8.13; also elsewhere on the board
/Connectors/filter_freq: J8.15; also elsewhere on the board
/Connectors/filter_resonance: J8.16; also elsewhere on the board
/Connectors/global_lfo_depth: J8.14; also elsewhere on the board
/Connectors/global_lfo_rate: J8.12; also elsewhere on the board
/Connectors/lfo_depth: J8.10; also elsewhere on the board
/Connectors/lfo_rate: J8.8; also elsewhere on the board
/Connectors/mod1: J8.17; also elsewhere on the board
/Connectors/mod2: J8.18; also elsewhere on the board
/Connectors/mod3: J8.19; also elsewhere on the board
/Connectors/mod4: J8.20; also elsewhere on the board
/Connectors/mod5: J8.21; also elsewhere on the board
/Connectors/mod6: J8.22; also elsewhere on the board
/Connectors/mod7: J8.23; also elsewhere on the board
/Connectors/mod8: J8.24; also elsewhere on the board
/Connectors/osc1_tune: J8.3; also elsewhere on the board
/Connectors/osc1_waveshape: J8.5; also elsewhere on the board
/Connectors/osc2_tune: J8.7; also elsewhere on the board
/Connectors/osc2_waveshape: J8.9; also elsewhere on the board
/Connectors/release: J8.6; also elsewhere on the board
/Connectors/sustain: J8.4; also elsewhere on the board

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
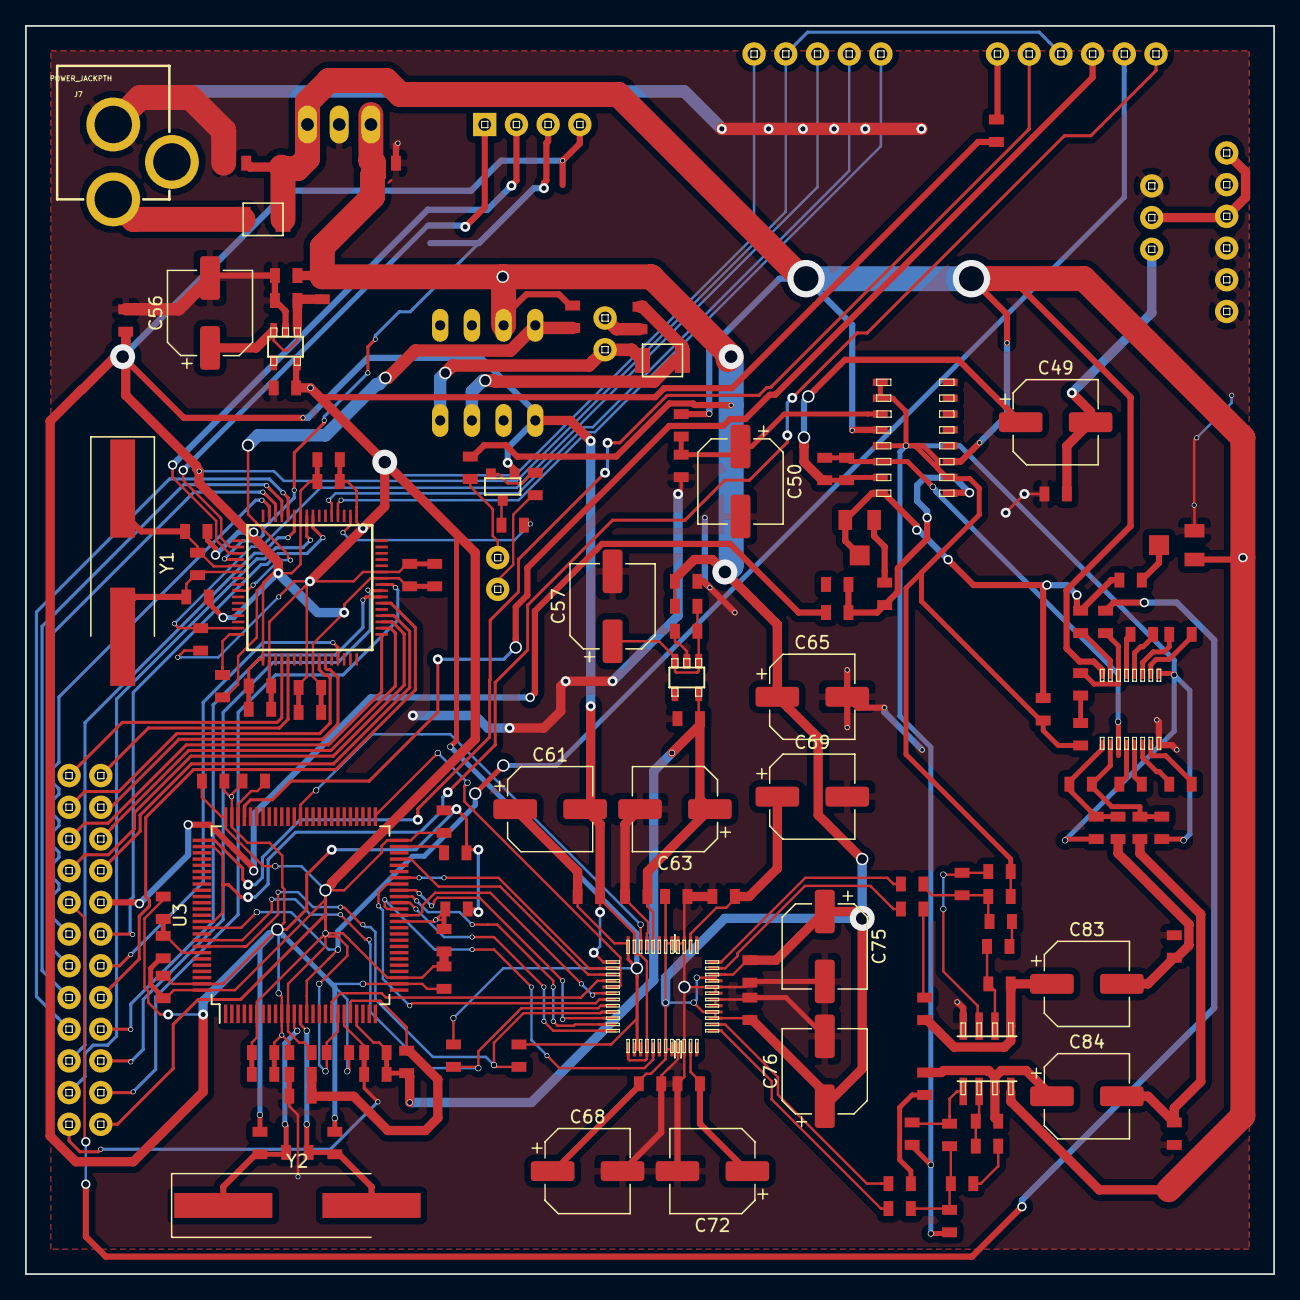
[picture p14: board synth-wavetable.kicad_pcb from above]

Board: 2 copper layers, 100.0 x 100.0 mm, 145 parts (1 on the bottom side), 117 nets.
