pmusgrave/synth-wavetable/Hardware/control/control.kicad_pcb

## KiCad design Hardware/control/control.kicad_pcb (2019-11-27)

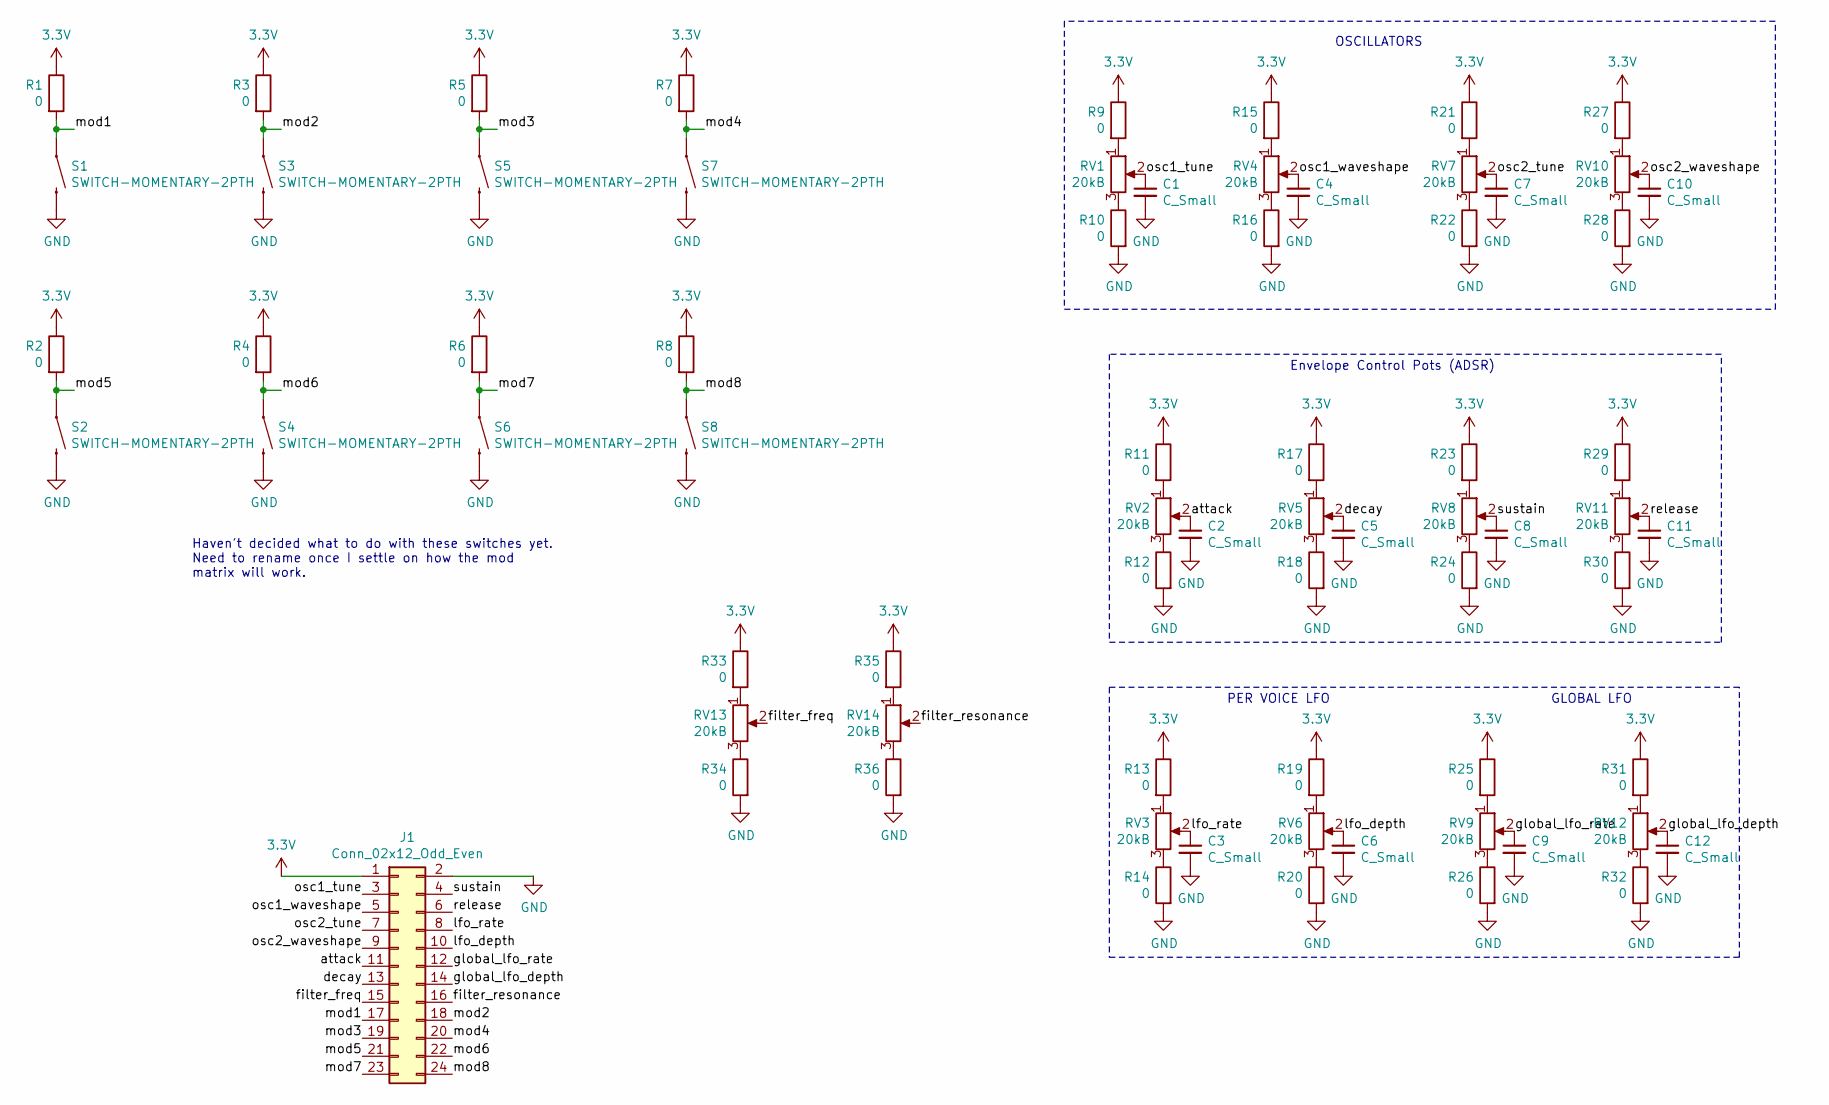
[picture p15: schematic control.sch]

Parts:
C1, C2, C3, C4, C5, C6, C7, C8, C9, C10, C11, C12: C_Small; 0805
J1: Conn_02x12_Odd_Even; 2X12
R1, R2, R3, R4, R5, R6, R7, R8, R9, R10, R11, R12, R13, R14, R15, R16, R17, R18, R19, R20, R21, R22, R23, R24, R25, R26, R27, R28, R29, R30, R31, R32, R33, R34, R35, R36: 0; 0805
RV1, RV2, RV3, RV4, RV5, RV6, RV7, RV8, RV9, RV10, RV11, RV12, RV13, RV14: 20kB; Potentiometer_Alps_RK09K_Single_Vertical
S1, S2, S3, S4, S5, S6, S7, S8: SWITCH-MOMENTARY-2PTH; TACTILE-PTH

Connections:
3.3V: J1.1, R1.1, R2.1, R3.1, R4.1, R5.1, R6.1, R7.1, R8.1, R9.1, R11.1, R13.1, R15.1, R17.1, R19.1, R21.1, R23.1, R25.1, R27.1, R29.1, R31.1, R33.1, R35.1
/attack: C2.1, J1.11, RV2.2
/decay: C5.1, J1.13, RV5.2
/filter_freq: J1.15, RV13.2
/filter_resonance: J1.16, RV14.2
/global_lfo_depth: C12.1, J1.14, RV12.2
/global_lfo_rate: C9.1, J1.12, RV9.2
/lfo_depth: C6.1, J1.10, RV6.2
/lfo_rate: C3.1, J1.8, RV3.2
/mod1: J1.17, R1.2, S1.1
/mod2: J1.18, R3.2, S3.1
/mod3: J1.19, R5.2, S5.1
/mod4: J1.20, R7.2, S7.1
/mod5: J1.21, R2.2, S2.1
/mod6: J1.22, R4.2, S4.1
/mod7: J1.23, R6.2, S6.1
/mod8: J1.24, R8.2, S8.1
/osc1_tune: C1.1, J1.3, RV1.2
/osc1_waveshape: C4.1, J1.5, RV4.2
/osc2_tune: C7.1, J1.7, RV7.2
/osc2_waveshape: C10.1, J1.9, RV10.2
/release: C11.1, J1.6, RV11.2
/sustain: C8.1, J1.4, RV8.2
GND: C1.2, C2.2, C3.2, C4.2, C5.2, C6.2, C7.2, C8.2, C9.2, C10.2, C11.2, C12.2, J1.2, R10.2, R12.2, R14.2, R16.2, R18.2, R20.2, R22.2, R24.2, R26.2, R28.2, R30.2, R32.2, R34.2, R36.2, S1.3 (2), S2.3 (2), S3.3 (2), S4.3 (2), S5.3 (2), S6.3 (2), S7.3 (2), S8.3 (2)
unnamed: R9.2, RV1.1
unnamed: R10.1, RV1.3
unnamed: R11.2, RV2.1
unnamed: R12.1, RV2.3
unnamed: R13.2, RV3.1
unnamed: R14.1, RV3.3
unnamed: R15.2, RV4.1
unnamed: R16.1, RV4.3
unnamed: R17.2, RV5.1
unnamed: R18.1, RV5.3
unnamed: R19.2, RV6.1
unnamed: R20.1, RV6.3
unnamed: R21.2, RV7.1
unnamed: R22.1, RV7.3
unnamed: R23.2, RV8.1
unnamed: R24.1, RV8.3
unnamed: R25.2, RV9.1
unnamed: R26.1, RV9.3
unnamed: R27.2, RV10.1
unnamed: R28.1, RV10.3
unnamed: R29.2, RV11.1
unnamed: R30.1, RV11.3
unnamed: R31.2, RV12.1
unnamed: R32.1, RV12.3
unnamed: R33.2, RV13.1
unnamed: R34.1, RV13.3
unnamed: R35.2, RV14.1
unnamed: R36.1, RV14.3

Notes on the sheet:
Envelope Control Pots (ADSR)
GLOBAL LFO
OSCILLATORS
PER VOICE LFO
Haven't decided what to do with these switches yet. Need to rename once I settle on how the mod matrix will work.

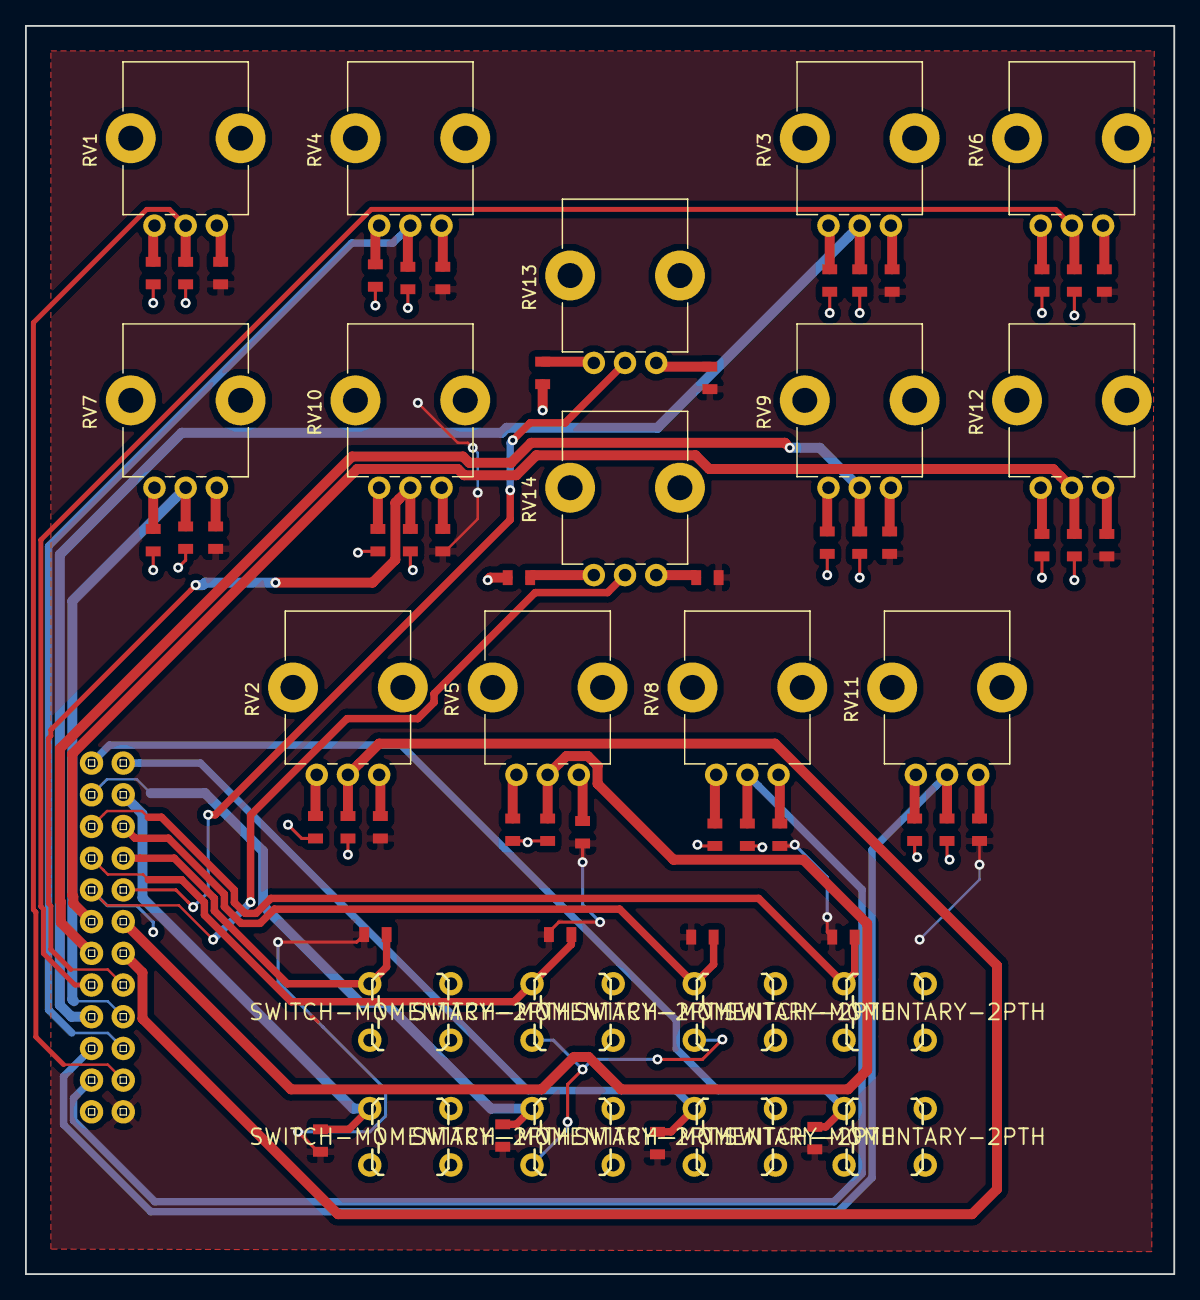
[picture p16: board control.kicad_pcb from above]

Board: 2 copper layers, 92.0 x 100.0 mm, 71 parts (0 on the bottom side), 52 nets.
