pmusgrave/synth-wavetable/STM32F4/STM32F4.ioc

Mcu.UserName=STM32F429VETx
PA0/WKUP.Signal=UART4_TX
PA1.Signal=UART4_RX
PA15.Signal=SPI1_NSS
PA4.Signal=COMP_DAC1_group
PA5.Signal=COMP_DAC2_group
PA6.Signal=SPI1_MISO
PA7.Signal=SPI1_MOSI
PB10.Signal=I2S2_CK
PB12.Signal=I2S2_WS
PB3.Signal=SPI1_SCK
PB6.Signal=I2C1_SCL
PB7.Signal=I2C1_SDA
PC2.Signal=I2S2_ext_SD
PC3.Signal=I2S2_SD
PC6.Signal=I2S2_MCK
PE10.Signal=GPIO_Output
PE11.Signal=GPIO_Output
PE12.Signal=GPIO_Output
PE13.Signal=GPIO_Output
PE7.Signal=GPIO_Output
PE8.Signal=GPIO_Output
PE9.Signal=GPIO_Output
