pmusgrave/synth-wavetable/Cypress/synth-wavetable.cydsn/AudioControl.h

/*******************************************************************************
* File Name: AudioControl.h
*
* Version 1.0
*
*  Description:  This file contains the Audio signal path configuration routine
*                declarations and constants.
*
*******************************************************************************
* Copyright (2018), Cypress Semiconductor Corporation. All rights reserved.
*******************************************************************************
* This software, including source code, documentation and related materials
* (“Software”), is owned by Cypress Semiconductor Corporation or one of its
* subsidiaries (“Cypress”) and is protected by and subject to worldwide patent
* protection (United States and foreign), United States copyright laws and
* international treaty provisions. Therefore, you may use this Software only
* as provided in the license agreement accompanying the software package from
* which you obtained this Software (“EULA”).
*
* If no EULA applies, Cypress hereby grants you a personal, nonexclusive,
* non-transferable license to copy, modify, and compile the Software source
* code solely for use in connection with Cypress’s integrated circuit products.
* Any reproduction, modification, translation, compilation, or representation
* of this Software except as specified above is prohibited without the express
* written permission of Cypress.
*
* Disclaimer: THIS SOFTWARE IS PROVIDED AS-IS, WITH NO WARRANTY OF ANY KIND, 
* EXPRESS OR IMPLIED, INCLUDING, BUT NOT LIMITED TO, NONINFRINGEMENT, IMPLIED 
* WARRANTIES OF MERCHANTABILITY AND FITNESS FOR A PARTICULAR PURPOSE. Cypress 
* reserves the right to make changes to the Software without notice. Cypress 
* does not assume any liability arising out of the application or use of the 
* Software or any product or circuit described in the Software. Cypress does 
* not authorize its products for use in any products where a malfunction or 
* failure of the Cypress product may reasonably be expected to result in 
* significant property damage, injury or death (“High Risk Product”). By 
* including Cypress’s product in a High Risk Product, the manufacturer of such 
* system or application assumes all risk of such use and in doing so agrees to 
* indemnify Cypress against all liability.
*******************************************************************************/

#ifndef AUDIOCONTROL_H
	#define AUDIOCONTROL_H

	#include <Config.h>
	#include <cytypes.h>

	#define FREQUENCY_NOT_SET	0xFF

	#if(USBFS_EP_MM != USBFS__EP_DMAAUTO) 
		#define NUM_TDS 8
		#define TRANS_SIZE 96
		#define BUFSIZE (TRANS_SIZE*NUM_TDS)
		#define HALF (BUFSIZE/2)
	#else
		#define NUM_TDS 1
		#define OUT_TRANS_SIZE 4096
		#define OUT_BUFSIZE (OUT_TRANS_SIZE*NUM_TDS)
		#define OUT_HALF (OUT_BUFSIZE/2)
	#endif

	#define AUDIOMAXPKT (IN_BUFSIZE/4)
	#define MAX_AUDIO_SAMPLE_SIZE                6	
	#define IN_AUDIOMAXPKT  (AUDIOMAXPKT + MAX_AUDIO_SAMPLE_SIZE)

	/* Clock Rates */
	#define RATE_48KHZ                                   0
	#define RATE_44KHZ                                   1	

	#define BUS_CLOCK_DIVIDE_BY_8                        0x07
	#define BUS_CLOCK_DIVIDE_BY_16                       0x0F
	#define BUS_CLOCK_DIVIDE_BY_2                        0x01

	#define ANALOG_AUX_INPUT                             0

	#define SAMPLING_RATE_48KHZ                          48000	
	#define SAMPLING_RATE_44KHZ                          44100

	#define FIFO_HALF_EMPTY_MASK                         0x0C
	
	extern uint8 audioClkConfigured;
	
	void InitAudioPath(void);
	void SetClockRate(uint8 newRate);
	void Stop_I2S_Tx(void);	
	//void HandleSamplingFrequencyChangeRequest(void);	
	//void HandleAudioInBuffer(void);
#endif /* #ifndef AUDIOCONTROL_H */

/* [] END OF FILE */
