pmusgrave/synth-wavetable/STM32F4/Src/midi.c

#include "midi.h"
#include "globals.h"
#include <stdint.h>

volatile struct midi_msg current_midi_msg = {0,0,0,0};
struct msg_queue  midi_msg_queue;

volatile uint8_t MIDI_flag = 0;

const float midi_notes[88] = {
                               27.5,
                               29.13524,
                               30.86771,
                               32.7032,
                               34.64783,
                               36.7081,
                               38.89087,
                               41.20344,
                               43.65353,
                               46.2493,
                               48.99943,
                               51.91309,
                               55,
                               58.27047,
                               61.73541,
                               65.40639,
                               69.29566,
                               73.41619,
                               77.78175,
                               82.40689,
                               87.30706,
                               92.49861,
                               97.99886,
                               103.8262,
                               110,
                               116.5409,
                               123.4708,
                               130.8128,
                               138.5913,
                               146.8324,
                               155.5635,
                               164.8138,
                               174.6141,
                               184.9972,
                               195.9977,
                               207.6523,
                               220,
                               233.0819,
                               246.9417,
                               261.6256,
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
};

void Receive_MIDI(SPI_HandleTypeDef* hspi, uint8_t* spi_rx_buffer) {
  //  if(!HAL_GPIO_ReadPin(GPIOF,GPIO_PIN_6) &&
  if(HAL_SPI_GetState(hspi) == HAL_SPI_STATE_READY) {
    uint8_t data = 0xAA;
    HAL_SPI_TransmitReceive_IT(hspi, &data, spi_rx_buffer, 1);
  }
}

void enqueue (struct midi_msg midi_msg) {
  midi_msg_queue.queue[midi_msg_queue.head++] = midi_msg;
}

struct midi_msg dequeue(void) {
  return midi_msg_queue.queue[midi_msg_queue.tail++];
}
