pmusgrave/synth-wavetable/Cypress/synth-wavetable.cydsn/oscillator.c

#include "project.h"
#include "oscillator.h"
#include "waves.h"
#include "globals.h"

double music_notes[99] = {
    9.0110625,
    9.5484495,
    10.11532725,
    10.7149725,
    11.35393875,
    12.02894925,
    12.74328075,
    13.50021,
    14.30301375,
    15.15496875,
    16.056075,
    17.00960925,
    18.022125,
    19.09362225,
    20.2306545,
    21.43322175,
    22.7078775,
    24.0578985,
    25.4865615,
    27.00369675,
    28.60930425,
    30.3099375,
    32.11215,
    34.02249525,
    36.04425,
    38.1872445,
    40.45803225,
    42.86316675,
    45.41247825,
    48.11252025,
    50.973123,
    54.00411675,
    57.21533175,
    60.619875,
    64.2243,
    68.04171375,
    72.0885,
    76.374489,
    80.9160645,
    85.72961025,
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
};



void ProcessVoice(struct voice* v) {
    /*
    switch((*v).current_env_mode){
    case ATTACK_MODE:
        (*v).env_index += attack_freq;
        (*v).env_multiplier = base_pos_saw[((*v).env_index>>20) & 0xFFF]; // using pos saw wave here, but should rename to linear ramp or something
        if((*v).env_multiplier > 120) {
            (*v).env_multiplier  = 127;
            (*v).current_env_mode = DECAY_MODE;
        }
        break;
    case DECAY_MODE:
        (*v).env_index -= decay_freq;
        (*v).env_multiplier = base_pos_saw[((*v).env_index>>20) & 0xFFF];
        if((*v).env_multiplier < base_pos_saw[(sustain_freq) & 0xFFF]) {
            (*v).env_multiplier = base_pos_saw[(sustain_freq) & 0xFFF];
            (*v).current_env_mode = SUSTAIN_MODE;
        }
        break;
    case SUSTAIN_MODE:
        (*v).env_multiplier = base_pos_saw[(sustain_freq) & 0xFFF];
        break;
    case RELEASE_MODE:
        (*v).env_index -= release_freq;
        (*v).env_multiplier = base_pos_saw[((*v).env_index>>20) & 0xFFF];
        if((*v).env_multiplier < 10) {
            (*v).env_multiplier = 0;
            (*v).env_index = 0;
            (*v).current_env_mode = NOT_TRIGGERED;
        }
        break;
    }
    */
}

void DispatchNote(uint8 note) {
    /*
    freq = music_notes[note-21] * 20;
    
    if(v1.current_env_mode == NOT_TRIGGERED){
        v1.freq = freq;
        v1.note_index = note;
        v1.current_env_mode = SUSTAIN_MODE;
        return;
    }
    else if(v2.current_env_mode == NOT_TRIGGERED){
        v2.freq = freq;
        v2.note_index = note;
        v2.current_env_mode = SUSTAIN_MODE;
        return;
    }
    else if(v3.current_env_mode == NOT_TRIGGERED){
        v3.freq = freq;
        v3.note_index = note;
        v3.current_env_mode = SUSTAIN_MODE;
        return;
    }
    else if(v4.current_env_mode == NOT_TRIGGERED){
        v4.freq = freq;
        v4.note_index = note;
        v4.current_env_mode = SUSTAIN_MODE;
        return;
    }
    else if(v5.current_env_mode == NOT_TRIGGERED){
        v5.freq = freq;
        v5.note_index = note;
        v5.current_env_mode = SUSTAIN_MODE;
        return;
    }
    else if(v6.current_env_mode == NOT_TRIGGERED){
        v6.freq = freq;
        v6.note_index = note;
        v6.current_env_mode = SUSTAIN_MODE;
        return;
    }
    else if(v7.current_env_mode == NOT_TRIGGERED){
        v7.freq = freq;
        v7.note_index = note;
        v7.current_env_mode = SUSTAIN_MODE;
        return;
    }
    else if(v8.current_env_mode == NOT_TRIGGERED){
        v8.freq = freq;
        v8.note_index = note;
        v8.current_env_mode = SUSTAIN_MODE;
        return;
    }
    */
}

void NoteOff(uint8 note){
    /*
    if(v1.note_index == note){
        v1.current_env_mode = NOT_TRIGGERED;
        v1.env_multiplier = 0;
    }
    else if(v2.note_index == note){
        v2.current_env_mode = NOT_TRIGGERED;
        v2.env_multiplier = 0;
    }
    else if(v3.note_index == note){
        v3.current_env_mode = NOT_TRIGGERED;
        v3.env_multiplier = 0;
    }
    else if(v4.note_index == note){
        v4.current_env_mode = NOT_TRIGGERED;
        v4.env_multiplier = 0;
    }
    else if(v5.note_index == note){
        v5.current_env_mode = NOT_TRIGGERED;
        v5.env_multiplier = 0;
    }
    else if(v6.note_index == note){
        v6.current_env_mode = NOT_TRIGGERED;
        v6.env_multiplier = 0;
    }
    else if(v7.note_index == note){
        v7.current_env_mode = NOT_TRIGGERED;
        v7.env_multiplier = 0;
    }
    else if(v8.note_index == note){
        v8.current_env_mode = NOT_TRIGGERED;
        v8.env_multiplier = 0;
    }
    */
}

/* [] END OF FILE */
