pmusgrave/synth-wavetable/Cypress/synth-wavetable.cydsn/globals.h

#include <project.h>

/* LED control defines. LED is active low. */
#define     LED_ON              0
#define     LED_OFF             1

#define     BUFFER_SIZE        3
extern uint8_t masterTxBuffer[BUFFER_SIZE];
extern uint8_t masterRxBuffer[BUFFER_SIZE];
extern volatile int8_t* current_buffer;

extern uint32_t lfo_freq;
extern uint16_t lfo_multiplier;
extern uint16_t envelope_multiplier;
extern uint16_t attack_freq;
extern uint16_t decay_freq;
extern uint16_t sustain_freq;
extern uint16_t release_freq;
extern uint16_t waveshape;

extern volatile uint8_t DMA_done_flag;
extern volatile uint8_t DMA_counter;
extern volatile uint8_t FIFO_DMA_REQ_FLAG;
extern volatile uint8_t update_ADC_flag;
extern volatile uint8_t trigger_flag;
extern volatile uint8_t MIDI_CC_update_flag;

extern int8_t output_buffer[];
extern int8_t output_buffer2[];
extern uint32_t buffer_index;
extern uint32_t buffer_index2;

extern const uint8 CYCODE MIDI_IDENTITY_REPLY[];
extern uint8 midiMsg[];
extern struct msg_queue midi_msg_queue;
/* Need for Identity Reply message */
extern volatile uint8 USB_MIDI1_InqFlags;
extern volatile uint8 usbActivityCounter;
extern uint8 inqFlagsOld;

/* [] END OF FILE */
