pmusgrave/synth-wavetable/(commit log)

2019-09-19 start configuring audio path * add UART debug strings * fix codec initialization * remove dynamically allocated memory for now due to bugs * decrease number of samples per wave to a 100 Hz rate
    [AudioControl.c, AudioControl.h, AudioOut.c, AudioOut.h, Codec.c, Codec.h, Config.h, Interrupts.c]
2019-09-19 test square wave and fix issue with incorrect buffer index
    [AudioOut.c, Interrupts.c, main.c, waves.c, waves.h]
2019-09-21 cleanest sine wave so far. * Fix a lot of DMA triggering. * Double buffer the I2S data. * Increase buffer size by factor of 10. * Disable interrupts while writing to initial buffer.
    [AudioControl.h, AudioOut.c, Interrupts.c, Interrupts.h, main.c, waves.c, waves.h]
2019-09-22 fix bug in generating ramp waveshapes
    [AudioOut.c, waves.c, waves.h]
2019-09-23 basic 2-voice polyphony. Has some timing issues.
    [AudioOut.c, Interrupts.c, waves.h]
2019-09-24 clean up unused code from Cypress examples. also add polyphony again with new method. Still haven't fixed timing issues. It's spending all its time doing math to fill the buffer and doesn't have enou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
    [AudioOut.c, Interrupts.c, globals.h, main.c]
2019-09-24 still working on DMA / buffering. Cleanest sine wave so far, but still lots of glitches.
    [AudioControl.c, AudioControl.h, AudioOut.c, AudioOut.h, Codec.h, Interrupts.c, Interrupts.h, globals.h]
2019-09-25 implement ping-pong double buffering. did not fix buffer timing issues
    [AudioControl.h, AudioOut.c, Interrupts.c, globals.h, main.c]
2019-09-25 tested and confirmed double buffering behavior but there is still a bug sending the correct samples to the DAC. It's no longer clicking due to buffer size, now it's a phase offset when the buffers ch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
    [AudioControl.h, AudioOut.c, Interrupts.c, main.c]
2019-09-25 change from multiplexed DMA triggers to single DMA component with chained descriptors. * significantly improved, but not perfect. * clean sine wave about half the time, clicking noise about half the 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
    [AudioControl.h, AudioOut.c, Interrupts.c, main.c]
2019-09-26 use 512 sample size for buffers. Cleanest sine wave so far.
2019-09-26 clean up unused test code. * remove TxDMA_ctrl stuff * remove commented out I2S disable code in ProcessAudioOut * also change buffer size to 1024 * for now, remove digital filter from ProcessAudioOut
2019-09-26 pushing limits of polyphony. Adding voices works fine, but when I scale values to prevent distortion, I run into buffer timing issues because it's too much math to do. I believe the buffer size is as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
    [AudioOut.c, globals.h, main.c]
2019-09-26 can handle 4 voice polyphony without buffer underrun. This only works when divisions are by powers of 2 (e.g. /8) because this compiles down to a bit shift and is fast enough. This is effectively the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
2019-09-26 can handle 8 voice polyphony by scaling the base wave amplitude. Dividing by the number of voices prevents the need to divide in the buffer processing function. This does reduce SNR, though.
    [AudioOut.c, main.c, waves.h]
2019-09-26 fix clicking sound when LFO reaches end of period
    [AudioControl.h, AudioOut.c, waves.c, waves.h]
2019-09-26 lfo pitch modulation
2019-09-27 add USB MIDI components print debug string to UART when midi notes messages are received
2019-09-27 import MIDI note array from previous project. Frequencies may not be correct, but synth responds to MIDI note changes
    [AudioOut.c, Interrupts.c, main.c, oscillator.c, oscillator.h]
2019-10-01 add SPI component in master mode * :change DMA descriptor to transfer between SPI Rx FIFO and I2S Tx FIFO
2019-10-09 use Cypress SPI example code to test SPI in isolation. Using Arduino as stand-in SPI slave device. Arduino transmits an incrementing integer.
2019-10-09 clean up DMA transfer code. Still having an issue with RAM to I2S FIFO DMA not triggering.
    [AudioOut.c, Interrupts.c, Interrupts.h, globals.h, main.c]
2019-10-09 successfully pass data through entire audio path. * Use chained DMA transfers with 2 buffers. * This confirms SPI->RAM->I2S codec audio path is configured correctly. * DO NOT change PSoC SPI configur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
    [AudioOut.c, Interrupts.c, globals.h, main.c]
2019-10-10 generate STM32 HAL code with CubeMX with SPI in full duplex slave mode.
2019-10-10 add sinewave table generation to STM32 and verify tool chain is set up correctly for this project.
    [main.c, waves.c, waves.h]
2019-10-11 successfully send data out of SPI. Data format/index are not correct, but this confirms the peripheral is configured correctly and sending out at least something.
    [main.c]
2019-10-11 send one sample at a time
2019-10-11 closest thing to a sinewave using SPI so far
2019-10-15 potentiometer control of FPGA frequency via SPI
2019-10-17 significantly clean up verilog code. * split register definitions near blocks where they are used * simplify SPI command switches and byte counting * change from less than/equal to byte counter to st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
2019-10-17 verify 16-bit values are being stored correctly in FPGA * needed to increment byte counter outside of all case statements and adjust how mosi_data_16bit was being updated
    [main.c]
2019-10-17 clean things up some more re-establish baseline. Clean sinewave output, SPI transactions are solid.
2019-10-19 improve receiving SPI commands and byte counting and change SPI commands to MIDI note messages
2019-10-20 change phase and output value to arrays, but having (presumably) timing issues when I try to increase the number of elements to anything greater than 8.
    [main.c]
2019-10-23 indicate voices active with leds
2019-10-24 significantly improved MIDI not synchronization and reduced note error rate. I don't know if it's 100% yet, but it's significantly better.
    [globals.h, main.c, oscillator.c]
2019-10-24 further reduce MIDI note error rate. The only detectable issue right now is sometimes note off messages are missed and the note stays on.
    [globals.h, main.c, oscillator.c, oscillator.h]
2019-10-24 block until SPI DMA is complete
2019-10-25 implement most of ADSR on FPGA. Release has some problems due to how note assignment currently works. Note assignment is not final though, so this can wait.
2019-10-26 divide by number of voices currently active. The result is not as good as I was hoping. It works, but there is noticeable volume drop when you add voices.
2019-10-27 change to Makefile generated code from STM32CubeMX. * Verify SPI reception is working * Add SPI slave select condition
2019-10-27 add MIDI Rx code currently untested
2019-10-28 working on MIDI note messages. * verify that setting a value in note_on array produces sinewave output. * MIDI messages via SPI not fully functioning yet.
2019-10-28 trigger a sinewave with a MIDI note on message via SPI
2019-10-30 add timer to more closely control sample rate * also clean things up a bit: * move phase accumulator update code into function * move R2R DAC update code into function
2019-10-30 rename "index" to phase_accumulator to avoid compiler warning.
    [main.c, waves.c, waves.h]
2019-10-30 clean up main DDS generator * fix output frequency precision: * only update output values based in timer ISR * this allows more control over the output frequency because it updates at a known rate. *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
    [main.c, midi.c, midi.h, waves.c, waves.h]
2019-11-06 use internal DAC instead of R2R not using DMA yet
2019-11-07 settle on 16 voice maximum with 48kHz sample rate. Also sum 2 waveforms per voice
2019-11-07 improve ADSR * add timer to trigger notes periodically (for testing) * improve ADSR ranges * doing this required modifying the DDS_SCALE_FACTOR constant which means the MIDI note table will have to b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
2019-11-08 reset lfo values when note is released. This should result in some neat per voice LFO phasing depending on when notes are pressed.
    [main.c]
2019-11-08 fix MIDI * change CPOL from low to high * improve MIDI note message state machine in main loop
    [main.c, midi.c, waves.h]
2019-11-08 change PSoC code to simply pass all MIDI messages through SPI link rather than dispatching to notes and checking note_on status
2019-11-09 add MIDI note message queue hopefully to avoid losing MIDI messages. Currently untested.
    [main.c]
2019-11-09 fix SPI DMA transfer size also change SPI polarity settings. Verified with UART that MIDI queue is sending out values as expected.
2019-11-12 add test MIDI notes to queue and change to single byte SPI transmissions at a time
2019-11-12 add pushbutton switch to make device send constant MIDI messages. Press switch to toggle between constant messages or MIDI messages from USB queue.
2019-11-12 fid MIDI bugs * read one SPI byte at a time * scan for NOTE ON/OFF messages * set flags to read following bytes
    [STM32F4.ioc, main.c, midi.c]
2019-11-12 add control change messages with ADSR values * change struct from midi_note_msg to more general midi_msg * create CC midi messages with ADC readings * enqueue CC midi messages along with note messages
2019-11-12 receive ADSR CC messages * currently untested because the PSoC is flooding the MIDI msg queue with ADSR values, which is causing note messages to be missed
    [main.c, midi.h]
2019-11-13 update ADSR values from MIDI CC messages. This currently has an issue where note messages are not recognized after the first CC.
    [main.c]
2019-11-13 fix NOTE/CC issue from previous commit
    [main.c]
2019-11-13 move debug UART code into functions to clean things up
2019-11-15 refactor main Cypress code. * clean things up considerably * remove dead UART, Codec, I2S code * move SPI code into separate files
2019-11-15 refactor STM32 code * move SPI, envelopes, global variables into separate files * fix basic SPI transactions with 1-byte-at-a-time blocking function calls
    [STM32F4.ioc, envelopes.c, envelopes.h, globals.h, main.c, spi_handler.c, spi_handler.h]
2019-11-16 set ADSR values in refactored version * still having some SPI bugs, but I think I can avoid them for now. * Whenever any ADSR pot value reaches 0x44, SPI loses synchronization * Refactor SPI code to 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
    [STM32F4.ioc, envelopes.c, envelopes.h, globals.h, main.c, r2rdac.c, spi_handler.c, spi_handler.h]
2019-11-18 change from SPI to UART on PSoC
2019-11-18 switch from SPI to UART Rx on STM32
2019-11-18 add oscillator code back into main application after all that refactoring
    [STM32F4.ioc, envelopes.c, envelopes.h, lfo.c, main.c, oscillator.c, oscillator.h]
2019-11-18 add sch and pcb layout files from v1 board. Basically, I just need to copy the microcontroller part and ditch the rest, but it'll save time to do that much.
    [connectors.sch, lfo.sch, mcu.sch, mixer.sch, out.sch, power.sch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]
2019-11-19 add waveshape ADC and CC MIDI message
2019-11-19 add STM32F429 to schematic and rename to current project name
    [audio-engine-2019-11-18-23-44-30.sch, audio-engine.sch, connectors-2019-11-18-23-44-30.sch, control-mcu-2019-11-18-23-44-30.sch, control-mcu.sch, lfo-2019-11-18-23-44-30.sch, mixer-2019-11-18-23-44-30.sch, power-2019-11-18-23-44-30.sch]
2019-11-19 restart Cypress schematic * I was running into some KiCAD library issues between Windows and Linux * So, just starting over from scratch on linux. * Add CY8C4246 to schematic * Add MIDI hardware to s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
    [audio-engine-2019-11-18-23-44-30.sch, audio-engine.sch, connectors-2019-11-18-23-44-30.sch, connectors.sch, control-mcu-2019-11-18-23-44-30.sch, control-mcu.sch, lfo-2019-11-18-23-44-30.sch, lfo.sch]
2019-11-19 add USB connector to Cypress schematic page
    [synth-wavetable.sch]
2019-11-19 add power regulation to schematic
    [audio-engine.sch, control-mcu.sch, filter.sch, power.sch, synth-wavetable.sch]
2019-11-19 add SSI2144 implementation * basically default datasheet version
    [filter.sch, synth-wavetable.sch]
2019-11-19 fix some ground/VREF mixups on filter schematic
    [audio-engine.sch, filter.sch]
2019-11-19 add 3.3V voltage regulator
    [power.sch]
2019-11-19 add STM32 voltage rails and bypass capacitors
    [audio-engine.sch]
2019-11-19 add SWD debugging/programming header to STM32 schematic
    [audio-engine.sch]
2019-11-19 add (optional) external crystal to STM32 schematic. I don't know if an external crystal is necessary or not but it's good to have pads for it on the board if I need it. As I understand it, timing cri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
    [audio-engine.sch]
2019-11-21 add 3.3V analog regulator and add power nets to AK4490
    [audio-engine.sch, control-mcu.sch, dac.sch, filter.sch, power.sch, synth-wavetable.sch]
2019-11-21 add potentiometers for 2 oscillators * I Think this will be all I need for potentiometers * Until I think of something else to add, of course. * Waveshape will be a continuous change through all of t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
    [control-mcu.sch]
2019-11-21 add filter potentiometers I believe filter is finalized now.
    [control-mcu.sch, filter.sch]
2019-11-21 add I/O connections between DAC and STM32 pages
    [audio-engine.sch, dac.sch, synth-wavetable.sch]
2019-11-21 add pullup resistors to I2C lines
    [control-mcu.sch, dac.sch]
2019-11-21 add missing ground connections to AK4490 Probably need to double check all the grounding on this again.
    [dac.sch]
2019-11-21 add LFP following DAC diff outputs and connect DAC output to VCF input
    [dac.sch, filter.sch, synth-wavetable.sch]
2019-11-21 add filtering in front of 3.3V regulators
    [audio-engine.sch, dac.sch, filter.sch, power.sch]
2019-11-21 clean up USB connector No need to connect this to anything other than PSoC
    [control-mcu.sch]
2019-11-21 add I2S, I2C, UART, DAC config pins to STM32
    [audio-engine.sch]
2019-11-22 assign footprints to schematic symbols.
    [audio-engine.sch, control-mcu.sch, dac.sch, filter.sch, power.sch, synth-wavetable.sch]
2019-11-22 initialize PCB layout files, generate netlist
    [synth-wavetable.kicad_pcb]
2019-11-22 rough placement and symbol organization. If I need to start PCB layout over from scracth, revert to this commit.
    [control-mcu.sch, dac.sch, filter.sch, power.sch, synth-wavetable.kicad_pcb]
2019-11-25 route 3.3VD voltage regulator and control MCU
    [control-mcu.sch, synth-wavetable.kicad_pcb]
2019-11-25 route STM32 bypass caps and programming header
    [synth-wavetable.kicad_pcb]
2019-11-26 add separate PCB with potentiometers and switches and connector between control board and synth engine
    [audio-engine.sch, connectors.sch, control-mcu.sch, control.kicad_pcb, control.sch, dac.sch, filter.sch, power.sch]
2019-11-26 route control board
    [control.kicad_pcb, synth-wavetable.kicad_pcb]
2019-11-27 initial routing complete. Still need to do ground plane pours. There are still some issues with incorrect footprints.
    [audio-engine.sch, connectors.sch, control-mcu.sch, control.kicad_pcb, control.sch, filter.sch, synth-wavetable.kicad_pcb, synth-wavetable.sch]
2019-11-27 add ground plane copper pours
    [synth-wavetable.kicad_pcb]
2019-12-03 fix some footprint errors
    [control-mcu.sch, filter.sch, power.sch, synth-wavetable.kicad_pcb]
2019-12-03 PCBv1 as built. generate BOM and gerbers
    [control-B.Cu.gbr, control-B.Mask.gbr, control-B.Paste.gbr, control-B.SilkS.gbr, control-Edge.Cuts.gbr, control-F.Cu.gbr, control-F.Mask.gbr, control-F.Paste.gbr]
2019-12-03 clean gerber directories for both boards and store v1 gerbers in a zip file
    [control-B.Cu.gbr, control-B.Mask.gbr, control-B.Paste.gbr, control-B.SilkS.gbr, control-Edge.Cuts.gbr, control-F.Cu.gbr, control-F.Mask.gbr, control-F.Paste.gbr]
2019-12-14 add pdf schematic
2019-12-19 port DAC code from previous project to STM32. No audio out yet, but I've verified STM32 is sending both I2C and I2S data
2019-12-19 port more recent I2C code from previous project. Previous commit used deprecated version for different codec IC. I2C is now more fully verified to be operational. Both SCL and SDA lines are toggling.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
